bpmine/modules_uino/README.md

# modules_uino
Quelques modules à base d'arduino
