bpmine/modules_uino/oisuino/readme.md

# CABANE OISEAU connectée

Dérivé de la cabane minou

- Détection mouvement
- Bandeau à LEDs
- Température
- Connection MQTT
