bpmine/modules_uino/semuino/images/illustrations.pptx

Nano

(Maître I²C)

I²C

RTC

5V

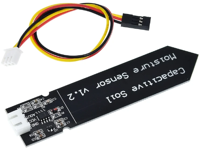
[picture p7: figure]

Humidity 1

Humidity 2

Humidity 3

DHT22
(Temp. / Hum.)

RGB1

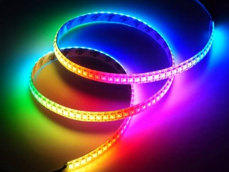
[picture p8: figure]

RGB2

RGB3

LED P1

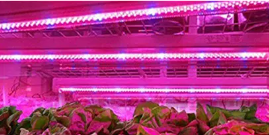
[picture p9: figure]

Sélecteur

LED P2

LED P3

## Slide 2

Nano

I²C

RTC

5V

Humidity 1

Humidity 2

Humidity 3

DHT22
(Temp. / Hum.)

RGB1

RGB2

RGB3

LED P1

Sélecteur

LED P2

LED P3

## Slide 3

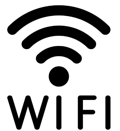
[picture p10: figure]

ESP01

(Maître I²C)

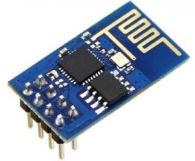
[picture p11: figure]

Ecran

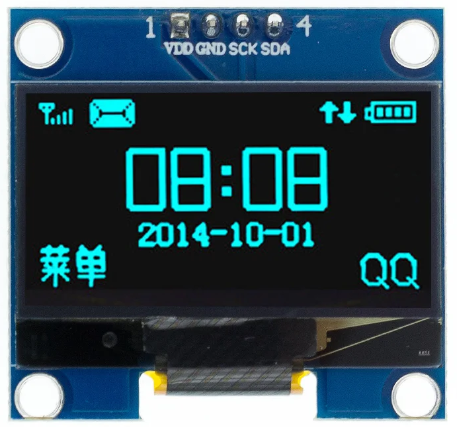
[picture p12: figure]
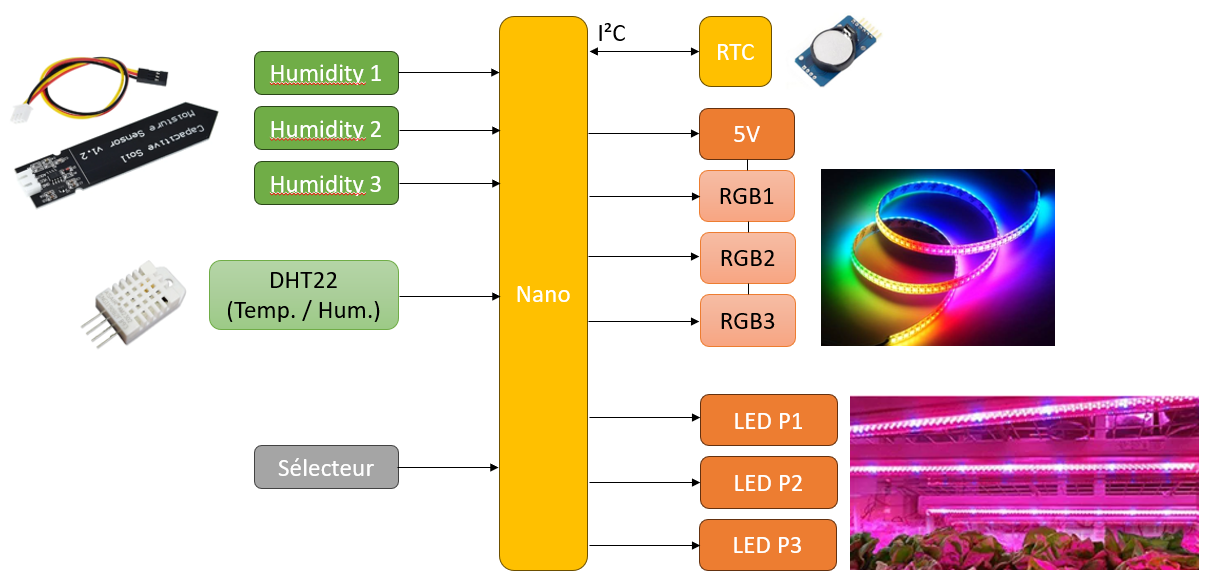
[picture p13: figure]
