bpmine/modules_uino/sonnette/doc.docx

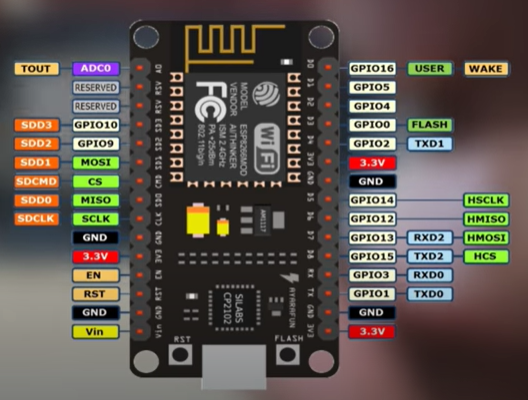
[picture p14: figure]

https://randomnerdtutorials.com/esp8266-pinout-reference-gpios/

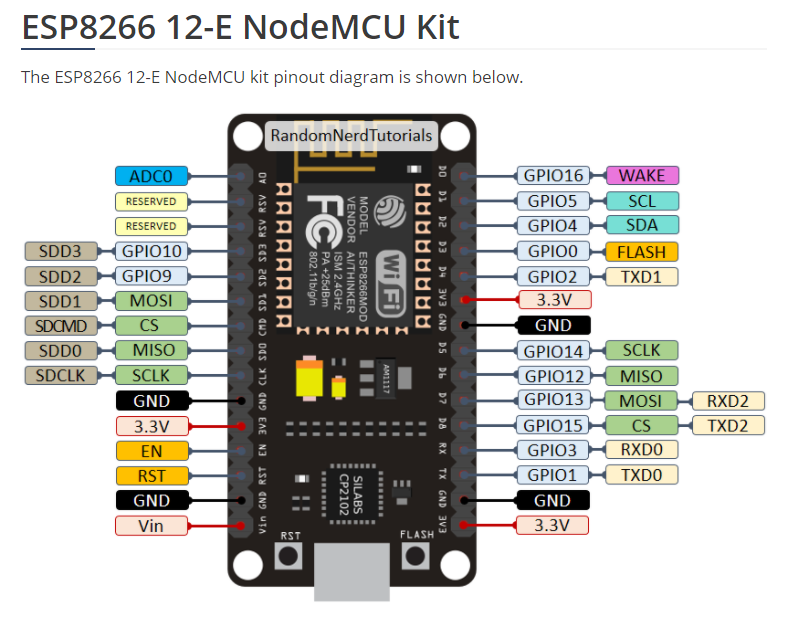
[picture p15: figure]
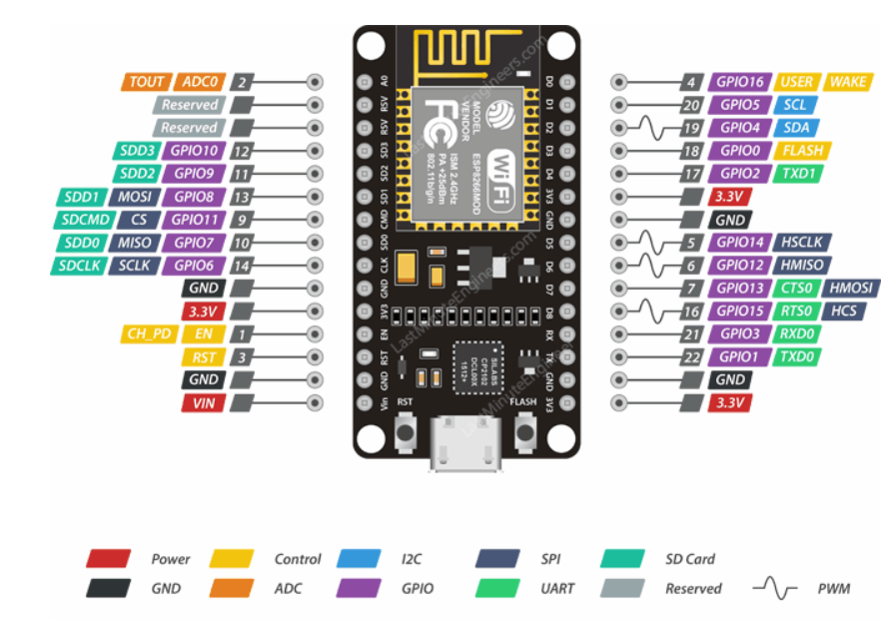
[picture p16: figure]
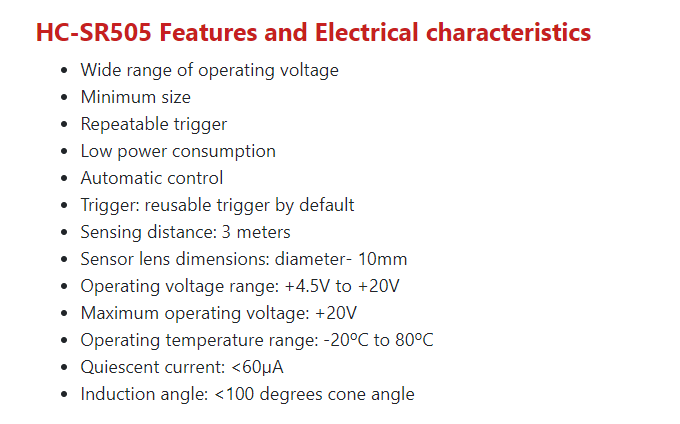
[picture p17: figure]
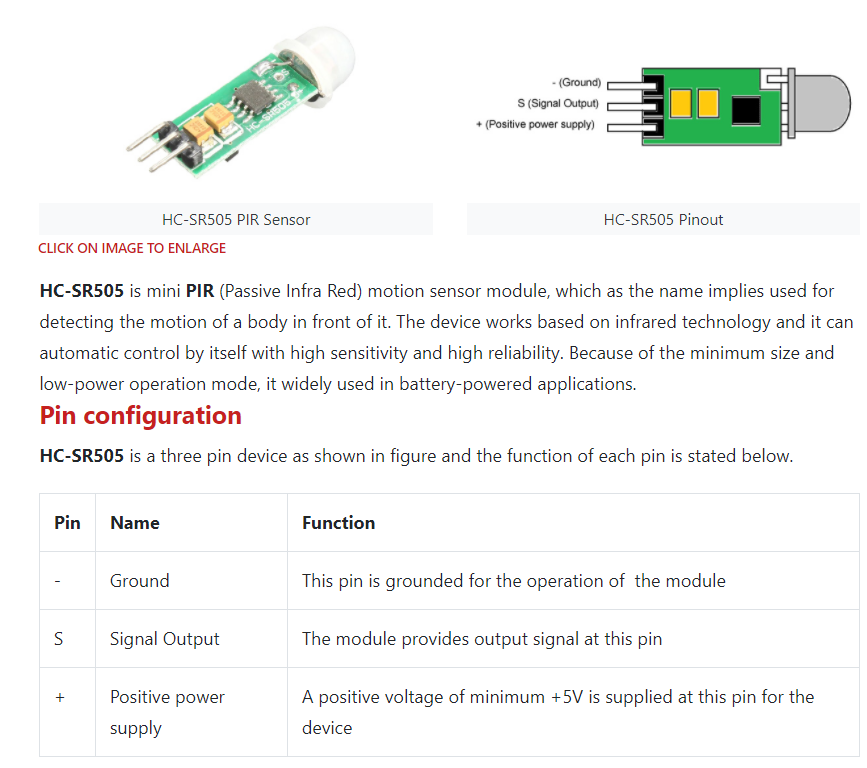
[picture p18: figure]
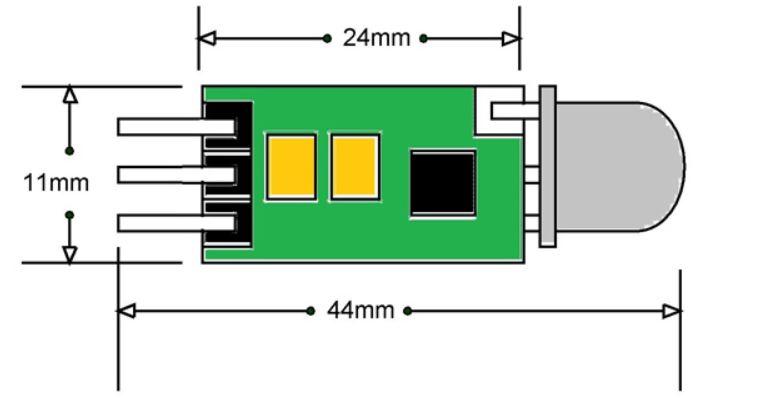
[picture p19: figure]
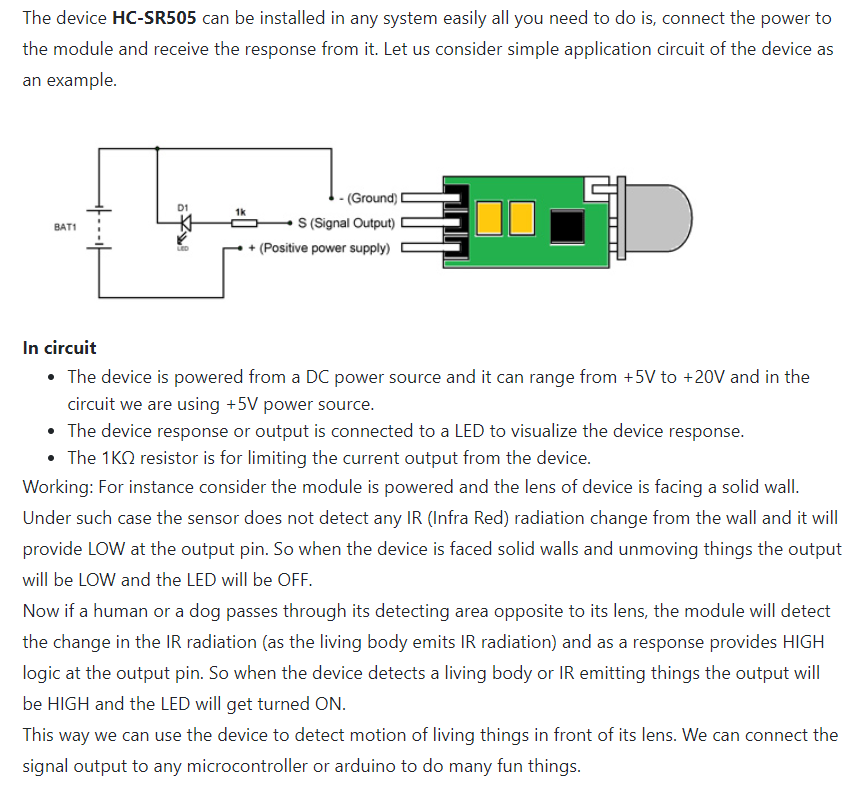
[picture p20: figure]
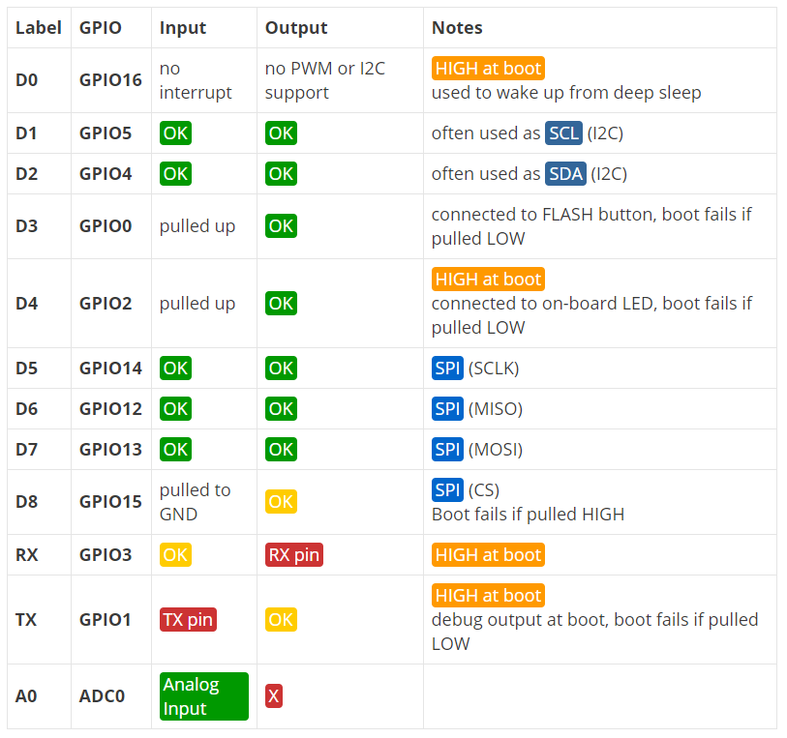
[picture p21: figure]
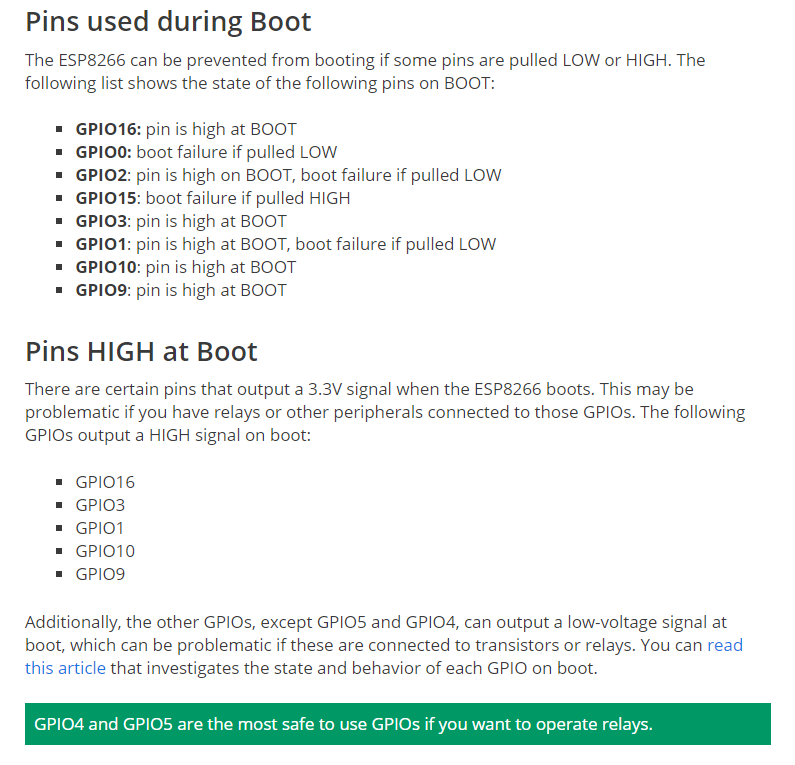
[picture p22: figure]
