bpmine/modules_uino/semuino/images/eclairage_blanc.png

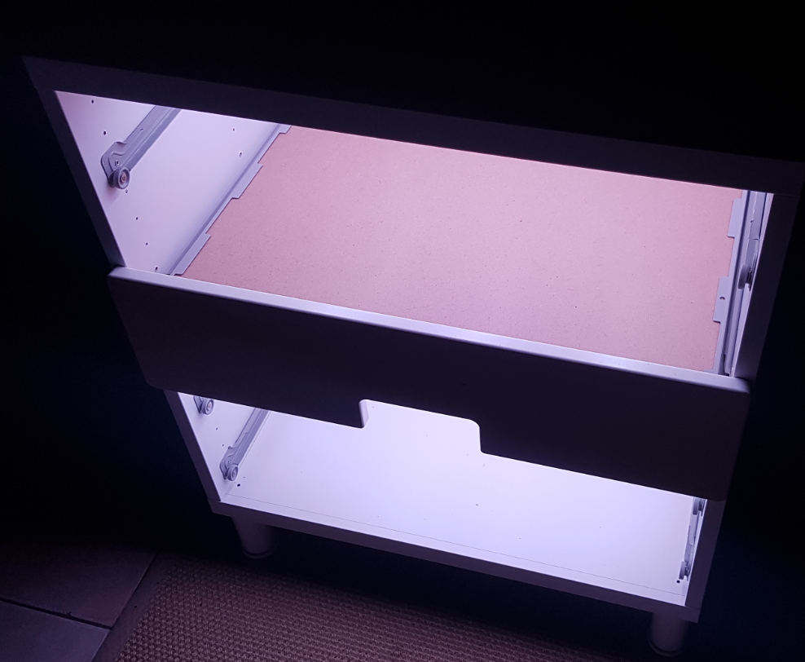
semuino/images/eclairage_blanc.png
