bpmine/modules_uino/semuino/images/eclairage_violet.png

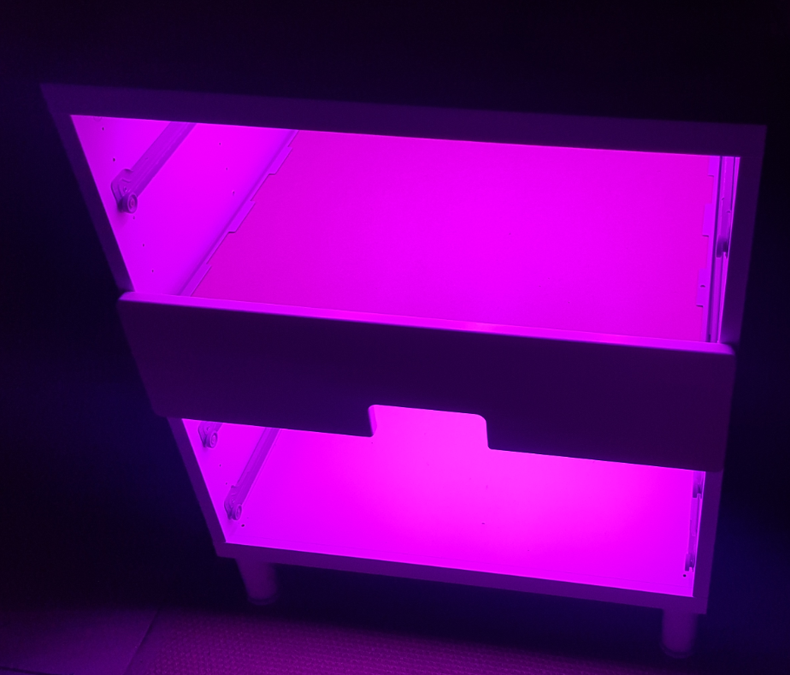
semuino/images/eclairage_violet.png
