bpmine/modules_uino/semuino/images/leds_tiroir.png

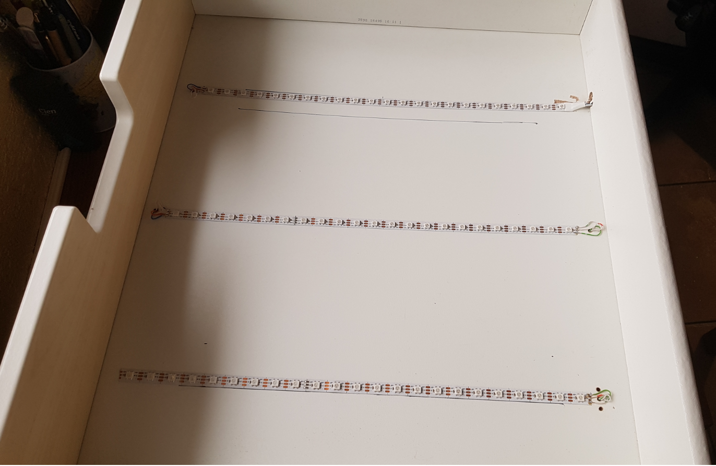
semuino/images/leds_tiroir.png
