bpmine/modules_uino/lcduino/hard/montage.FCStd

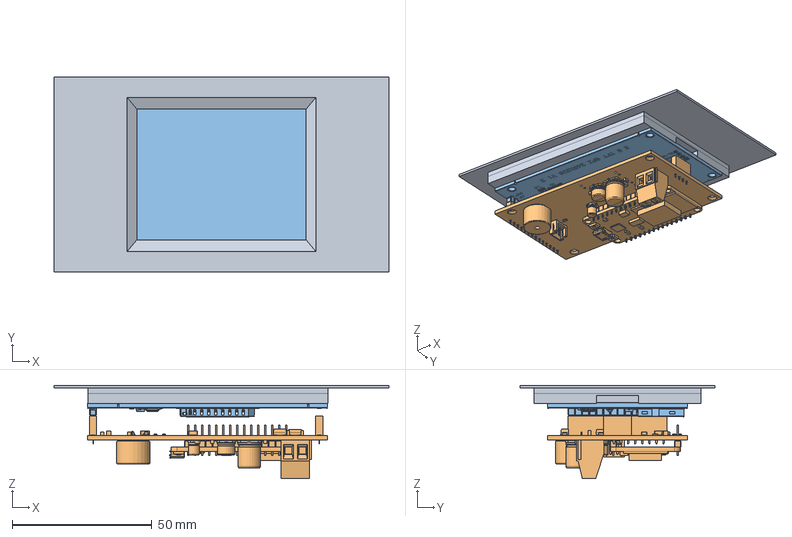
[picture p29: CAD file, 2026-10-17]
lcduino/hard/montage.FCStd
120.0 x 70.0 x 33.5 mm
lcduino
LCD_MSP2807_fusion
