bpmine/modules_uino/semuino/resultats.md

# Resultats

## Mesures avec le montage initial

Bandeau à LEDs de type WS2812B 5V 60LEDs/m 18W/m

Nombre de LEDs : 23 x 3 = 69

Temperature de la pièce: 20.5°C

Description | Mesure éclairage | Puissance électrique
-- | -- | --
Eclairage en 80%R / 20%B | 30 lux | 3,53 W
Eclairage en blanc | 660 lux | 7,38 W

Résultat: La lumière est insuffisante pour les premiers semis. Les plants montent trop vite.

## Mesures avec un dispositif horticole du marché

Nombre de LEDs : 20 x 3 = 60

Description | Mesure éclairage | Puissance électrique
-- | -- | --
Eclairage Rose/Violet 39 LEDs | 1018 lux | 6,33 W
Eclairage 39 rouges + 21 bleues | 213 lux | 8,96 W
Eclairage 21 bleues | 0 lux | 3,847 W

Les 0 lux obtenus avec le bleu sont dus à l'outil de mesure qui visiblement ne prend pas en compte la composante bleue.

## Mise à jour du dispositif avec plus de LEDs

On ajoute 4 rangées de LEDs WS2812B sur l'étage du haut.

Nombre de LEDs : 23 x 7 = 161

Description | Mesure éclairage | Puissance électrique
-- | -- | --
Eclairage en 80%R / 20%B | 90 lux | 7,70 W
Eclairage en blanc | 1553 lux | 13,25 W

Test en cours avec les mêmes plants repiqués dans des pots plus grands

## Mise à jour de l'étage du bas

On ajoute 4 rangées de LEDs WS2812B sur l'étage du haut.

Nombre de LEDs : 23 x 7 = 161

La consommation totale passe à 3.84A pour 5.08V, soit une puissance de 19.51W pour un éclairage blanc à 100% en haut et en bas.

Test en cours avec les mêmes plants repiqués dans des pots plus grands
