bpmine/modules_uino/(list of files, drawings)

Other design files:
semuino/schematic.fzz
sonnette/sonnette.fzz
