bpmine/modules_uino/lcduino/hard/lcduino.kicad_pcb

## KiCad design lcduino/hard/lcduino.kicad_pcb (2026-10-16)

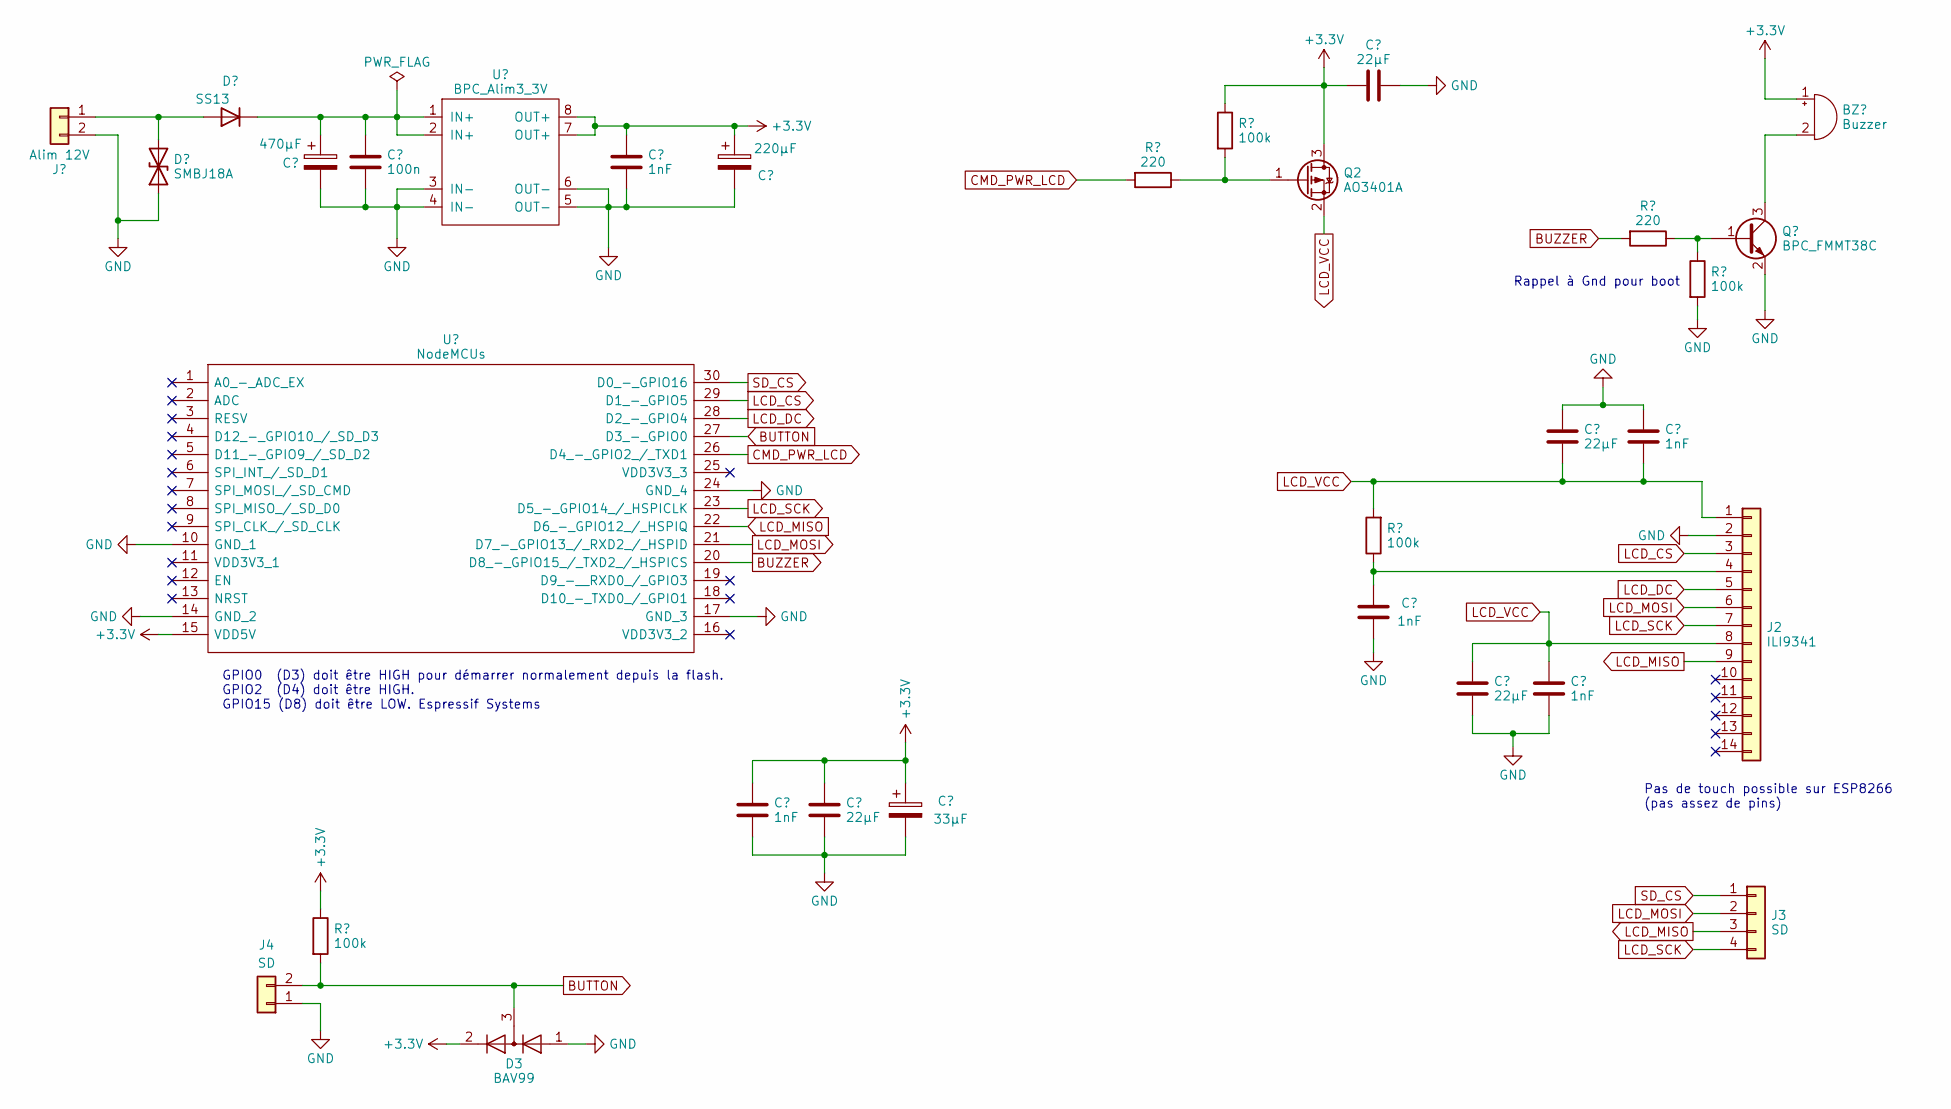
[picture p30: schematic lcduino.kicad_sch, Carte LCD Wifi]

Parts:
BZ1: Buzzer; MagneticBuzzer_ProSignal_ABT-410-RC
C1: 470µF; CP_Elec_8x10
C2: 100n; C_0805_2012Metric_Pad1.18x1.45mm_HandSolder
C3, C5, C8, C9, C13: 1nF; C_0805_2012Metric_Pad1.18x1.45mm_HandSolder
C4: 220µF; CP_Elec_6.3x5.3
C6, C10, C11, C12: 22µF; C_1206_3216Metric_Pad1.33x1.80mm_HandSolder
C7: 33µF; CP_Elec_4x5.3
D1: SMBJ18A; D_SMB_Handsoldering
D2: SS13; D_SMA
D3: BAV99; SOT-23
J1: Alim 12V; TerminalBlock_Phoenix_MKDS-1,5-2-5.08_1x02_P5.08mm_Horizont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
J2: ILI9341; PinSocket_1x14_P2.54mm_Vertical
J3: SD; PinSocket_1x04_P2.54mm_Vertical
J4: SD; JST_EH_B2B-EH-A_1x02_P2.50mm_Vertical
Q1: BPC_FMMT38C; BPC_SOT-23-3_HandSoldering
Q2: AO3401A; SOT-23
R1, R3: 220; R_0805_2012Metric_Pad1.20x1.40mm_HandSolder
R2, R4, R5, R6: 100k; R_0805_2012Metric_Pad1.20x1.40mm_HandSolder
U1: NodeMCUs; BPC_NodeMCU_small; Manufacturer_Part_Number 113990105; Mouser Part Number 713-113990105
U2: BPC_Alim3_3V

Connections:
+3.3V: BZ1.1 (-), C3.1, C4.1, C5.1, C6.1, C7.1, C11.1, D3.2 (A), Q2.3 (D), R4.1, R6.1, U1.15 (VDD5V), U2.7 (OUT+), U2.8 (OUT+)
BUTTON: D3.3 (K), J4.2, R6.2, U1.27 (D3_-_GPIO0)
BUZZER: R1.2, U1.20 (D8_-_GPIO15_/_TXD2_/_HSPICS)
CMD_PWR_LCD: R3.2, U1.26 (D4_-_GPIO2_/_TXD1)
GND: C1.2, C2.2, C3.2, C4.2, C5.2, C6.2, C7.2, C8.1, C9.1, C10.1, C11.2, C12.2, C13.2, D1.1 (A1), D3.1 (K), J1.2, J2.2, J4.1, Q1.2 (E), R5.2, U1.10 (GND_1), U1.14 (GND_2), U1.17 (GND_3), U1.24 (GND_4), U2.3 (IN-), U2.4 (IN-), U2.5 (OUT-), U2.6 (OUT-)
LCD_CS: J2.3, U1.29 (D1_-_GPIO5)
LCD_DC: J2.5, U1.28 (D2_-_GPIO4)
LCD_MISO: J2.9, J3.3, U1.22 (D6_-_GPIO12_/_HSPIQ)
LCD_MOSI: J2.6, J3.2, U1.21 (D7_-_GPIO13_/_RXD2_/_HSPID)
LCD_SCK: J2.7, J3.4, U1.23 (D5_-_GPIO14_/_HSPICLK)
LCD_VCC: C9.2, C10.2, C12.1, C13.1, J2.1, J2.8, Q2.2 (S), R2.2
unnamed: BZ1.2 (+), Q1.3 (C)
unnamed: D1.2 (A2), D2.2 (A), J1.1
unnamed: C1.1, C2.1, D2.1 (K), U2.1 (IN+), U2.2 (IN+)
unnamed: C8.2, J2.4, R2.1
unnamed: Q1.1 (B), R1.1, R5.1
unnamed: Q2.1 (G), R3.1, R4.2
SD_CS: J3.1, U1.30 (D0_-_GPIO16)

Notes on the sheet:
GPIO0 (D3) doit être HIGH pour démarrer normalement depuis la flash. GPIO2 (D4) doit être HIGH. GPIO15 (D8) doit être LOW. Espressif Systems
Pas de touch possible sur ESP8266 (pas assez de pins)
Rappel à Gnd pour boot

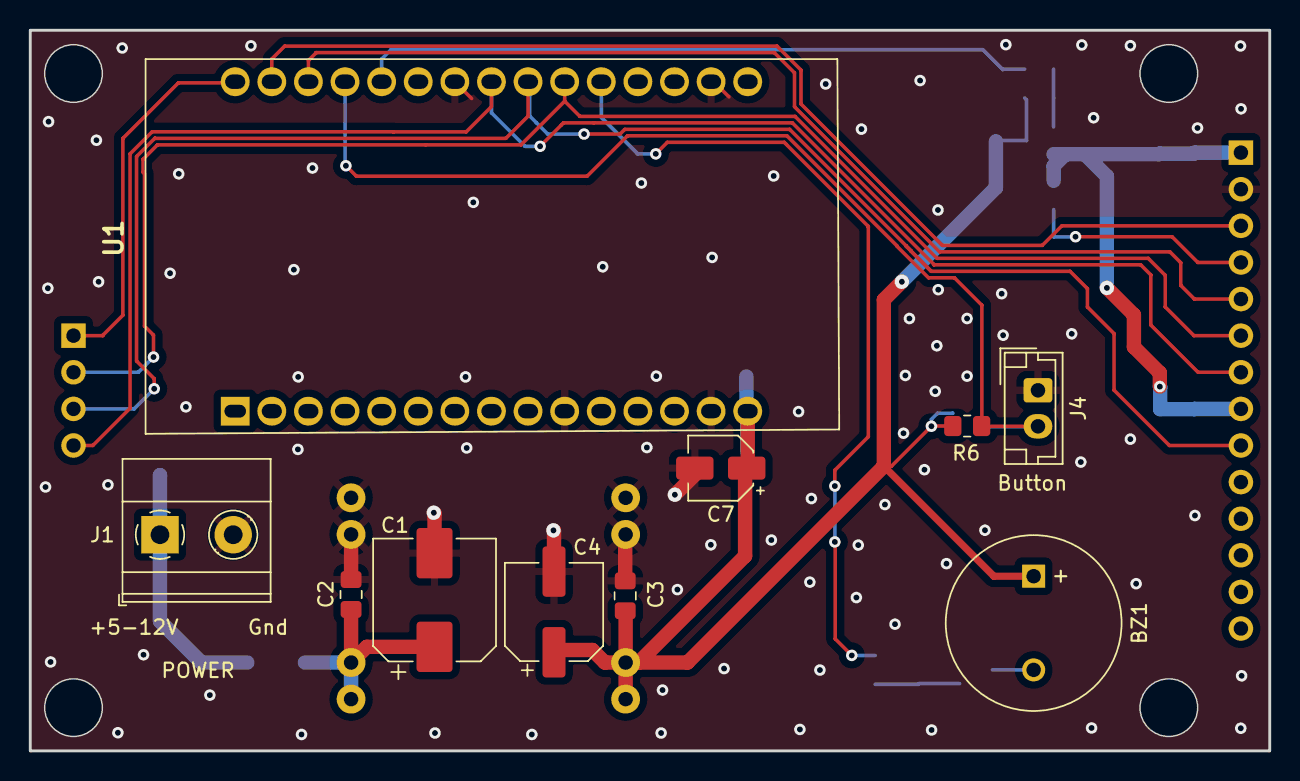
[picture p31: board lcduino.kicad_pcb from above]

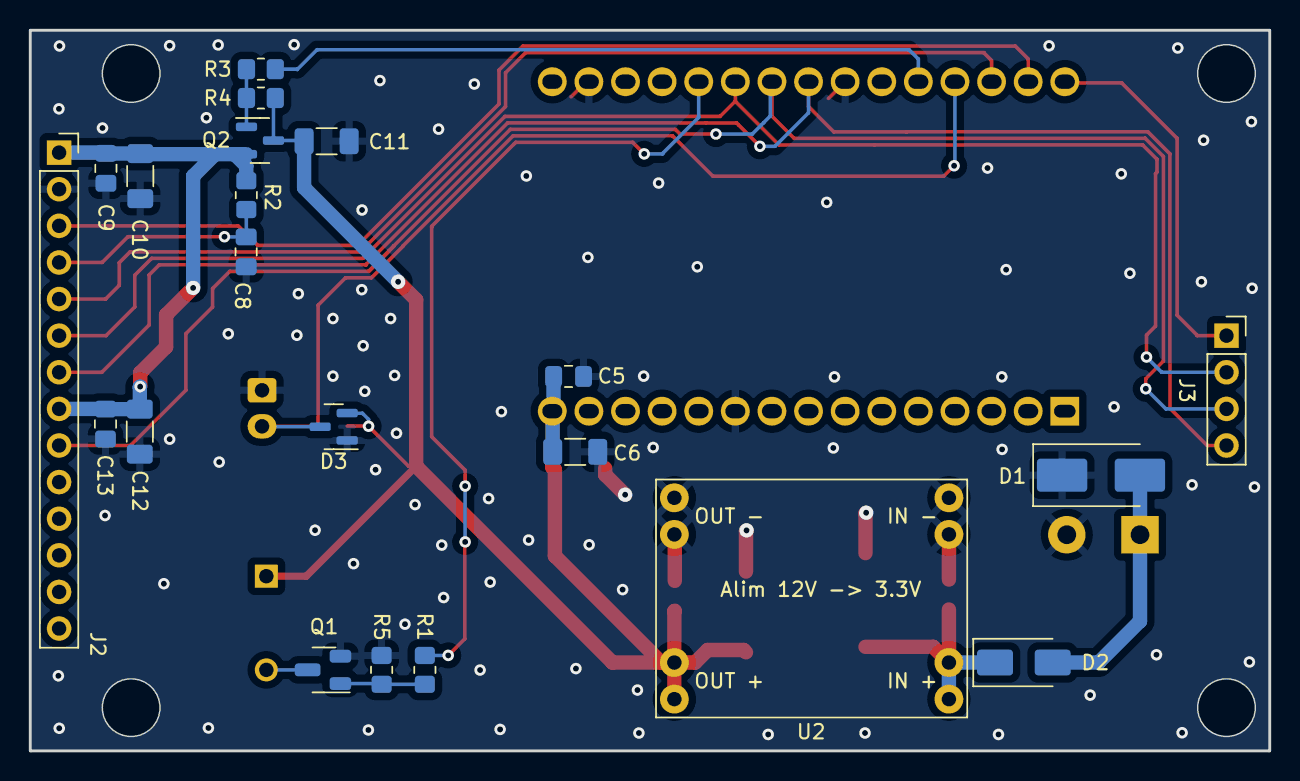
[picture p32: board lcduino.kicad_pcb from below]

Board: 2 copper layers, 86.0 x 50.0 mm, 31 parts (21 on the bottom side), 18 nets.
