bpmine/modules_uino/logger/logger/logger.kicad_pcb

## KiCad design logger/logger/logger.kicad_pcb (2024-06-10)

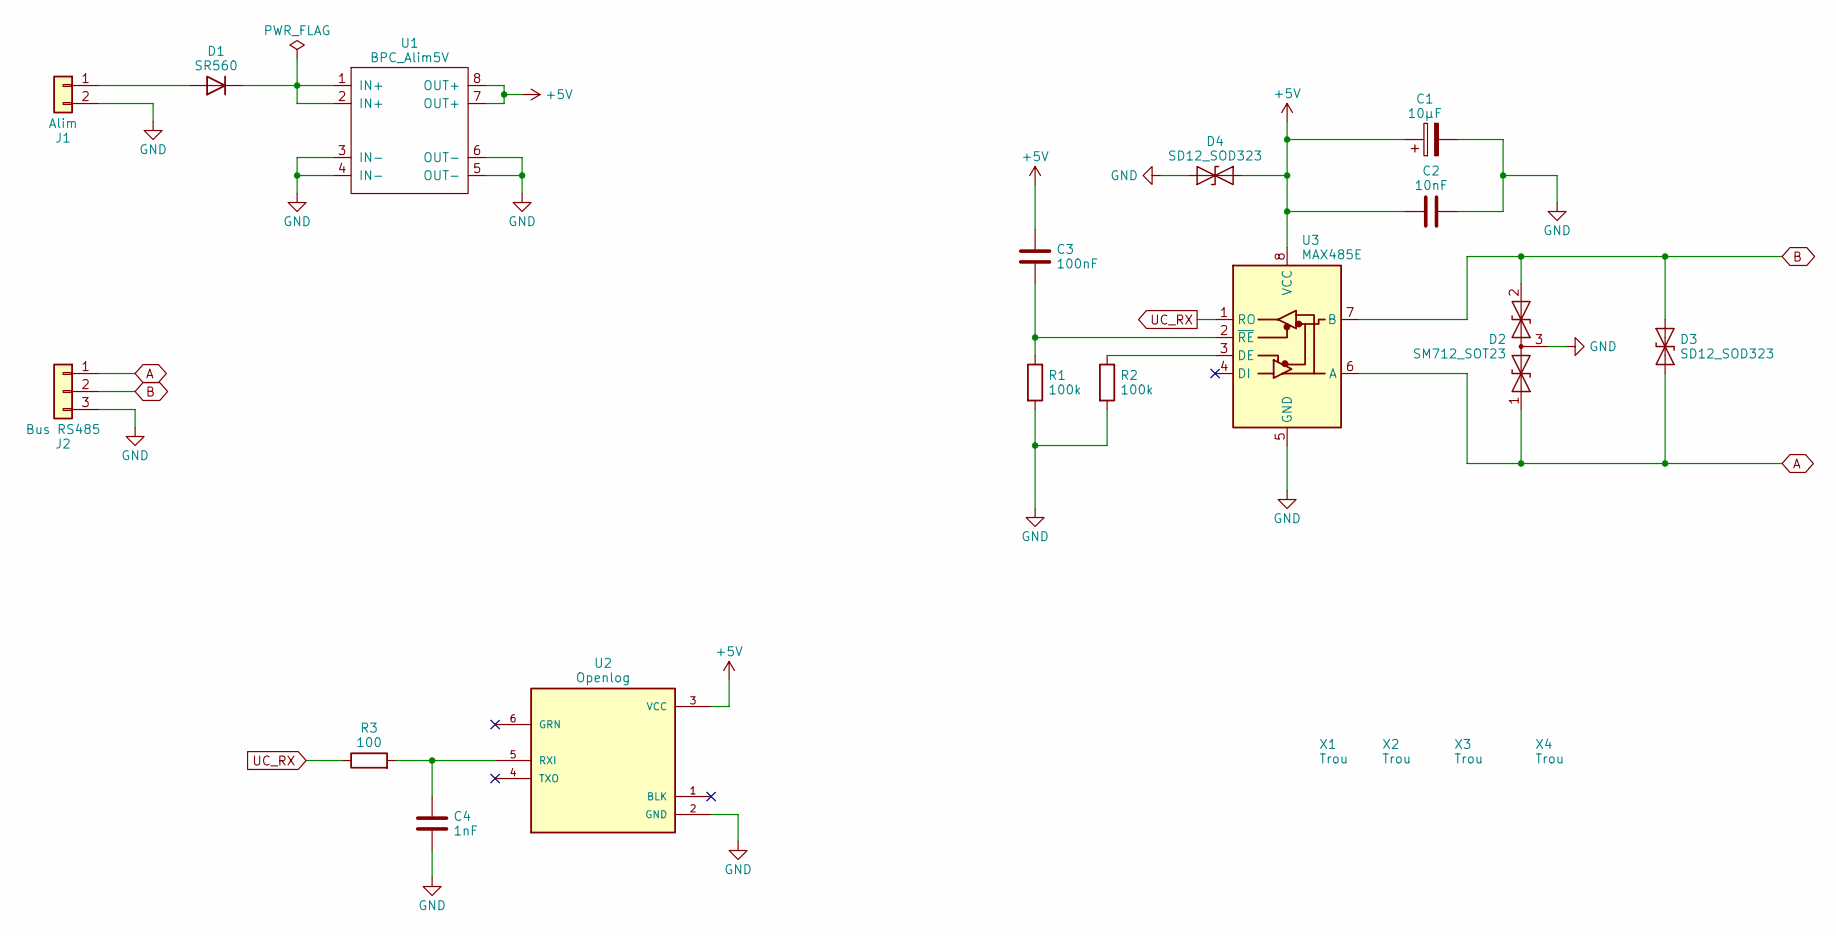
[picture p33: schematic logger.kicad_sch, Datalogger RS485]

Parts:
C1: 10µF; C_0805_2012Metric_Pad1.18x1.45mm_HandSolder
C2: 10nF; C_0805_2012Metric_Pad1.18x1.45mm_HandSolder
C3: 100nF; C_0805_2012Metric_Pad1.18x1.45mm_HandSolder
C4: 1nF; C_0805_2012Metric_Pad1.18x1.45mm_HandSolder
D1: SR560; D_DO-15_P12.70mm_Horizontal
D2: SM712_SOT23; SOT-23
D3, D4: SD12_SOD323; D_SOD-323
J1: Alim; TerminalBlock_Phoenix_MPT-0,5-2-2.54_1x02_P2.54mm_Horizontal
J2: Bus RS485; TerminalBlock_Phoenix_MPT-0,5-3-2.54_1x03_P2.54mm_Horizontal
R1, R2: 100k; R_0805_2012Metric_Pad1.20x1.40mm_HandSolder
R3: 100; R_0805_2012Metric_Pad1.20x1.40mm_HandSolder
U1: BPC_Alim5V
U2: Openlog; BPC_openlog; PARTREV v15
U3: MAX485E; BPC_MAX485E_SOIC127P600X175-8N
X1, X2, X3, X4: Trou; BPC_Trou4mm_Fixation

Connections:
+5V: C1.1, C2.1, C3.2, D4.1 (A1), U1.7 (OUT+), U1.8 (OUT+), U2.3 (VCC), U3.8 (VCC)
A: D2.1 (A1), D3.1 (A1), J2.1, U3.6 (A)
B: D2.2 (A2), D3.2 (A2), J2.2, U3.7 (B)
GND: C1.2, C2.2, C4.1, D2.3 (common), D4.2 (A2), J1.2, J2.3, R1.2, R2.2, U1.3 (IN-), U1.4 (IN-), U1.5 (OUT-), U1.6 (OUT-), U2.2 (GND), U3.5 (GND)
unnamed: D1.2 (A), J1.1
unnamed: D1.1 (K), U1.1 (IN+), U1.2 (IN+)
unnamed: C4.2, R3.2, U2.5 (RXI)
unnamed: R2.1, U3.3 (DE)
unnamed: C3.1, R1.1, U3.2 (~RE)
UC_RX: R3.1, U3.1 (RO)

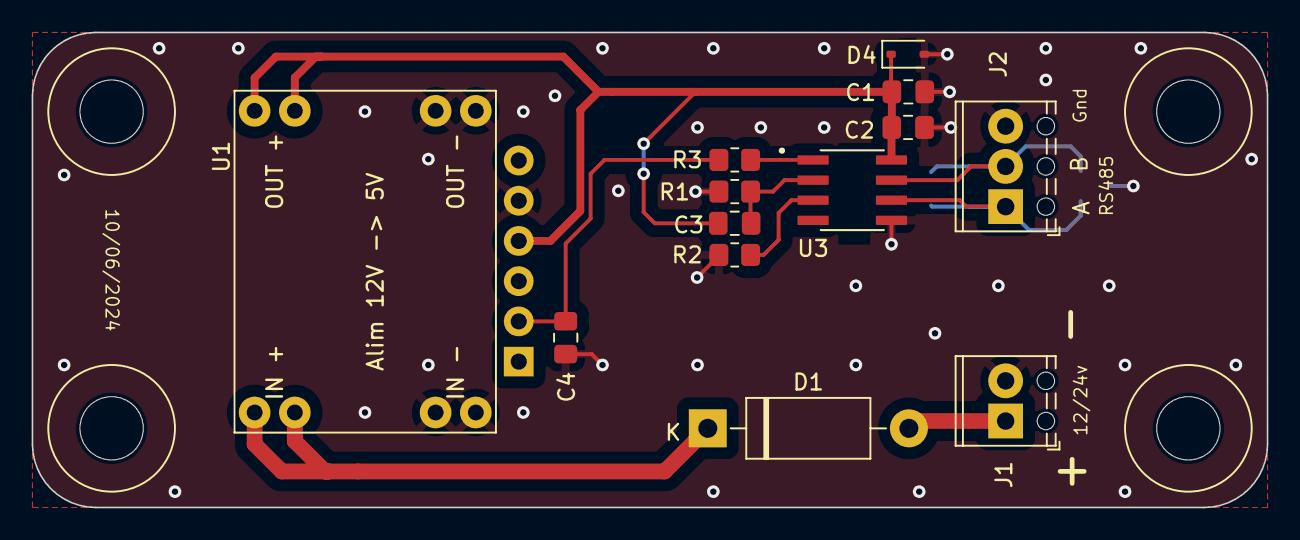
[picture p34: board logger.kicad_pcb from above]

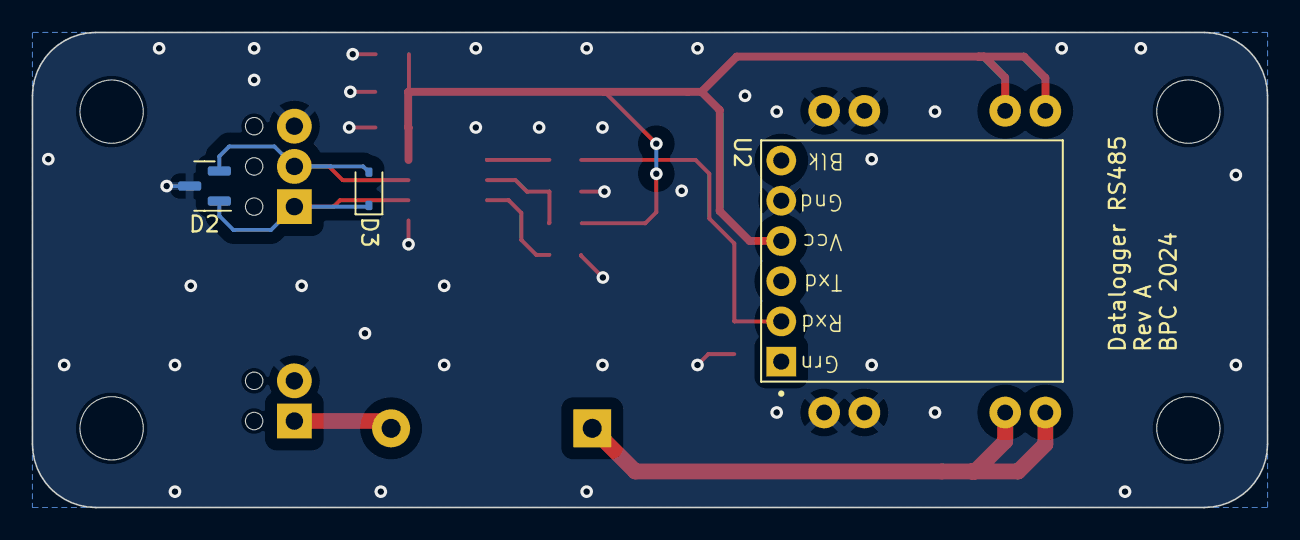
[picture p35: board logger.kicad_pcb from below]

Board: 2 copper layers, 78.0 x 30.0 mm, 20 parts (3 on the bottom side), 10 nets.
