bpmine/modules_uino/semuino/board/semuino/semuino.kicad_pcb

## KiCad design semuino/board/semuino/semuino.kicad_pcb (2023-12-23)

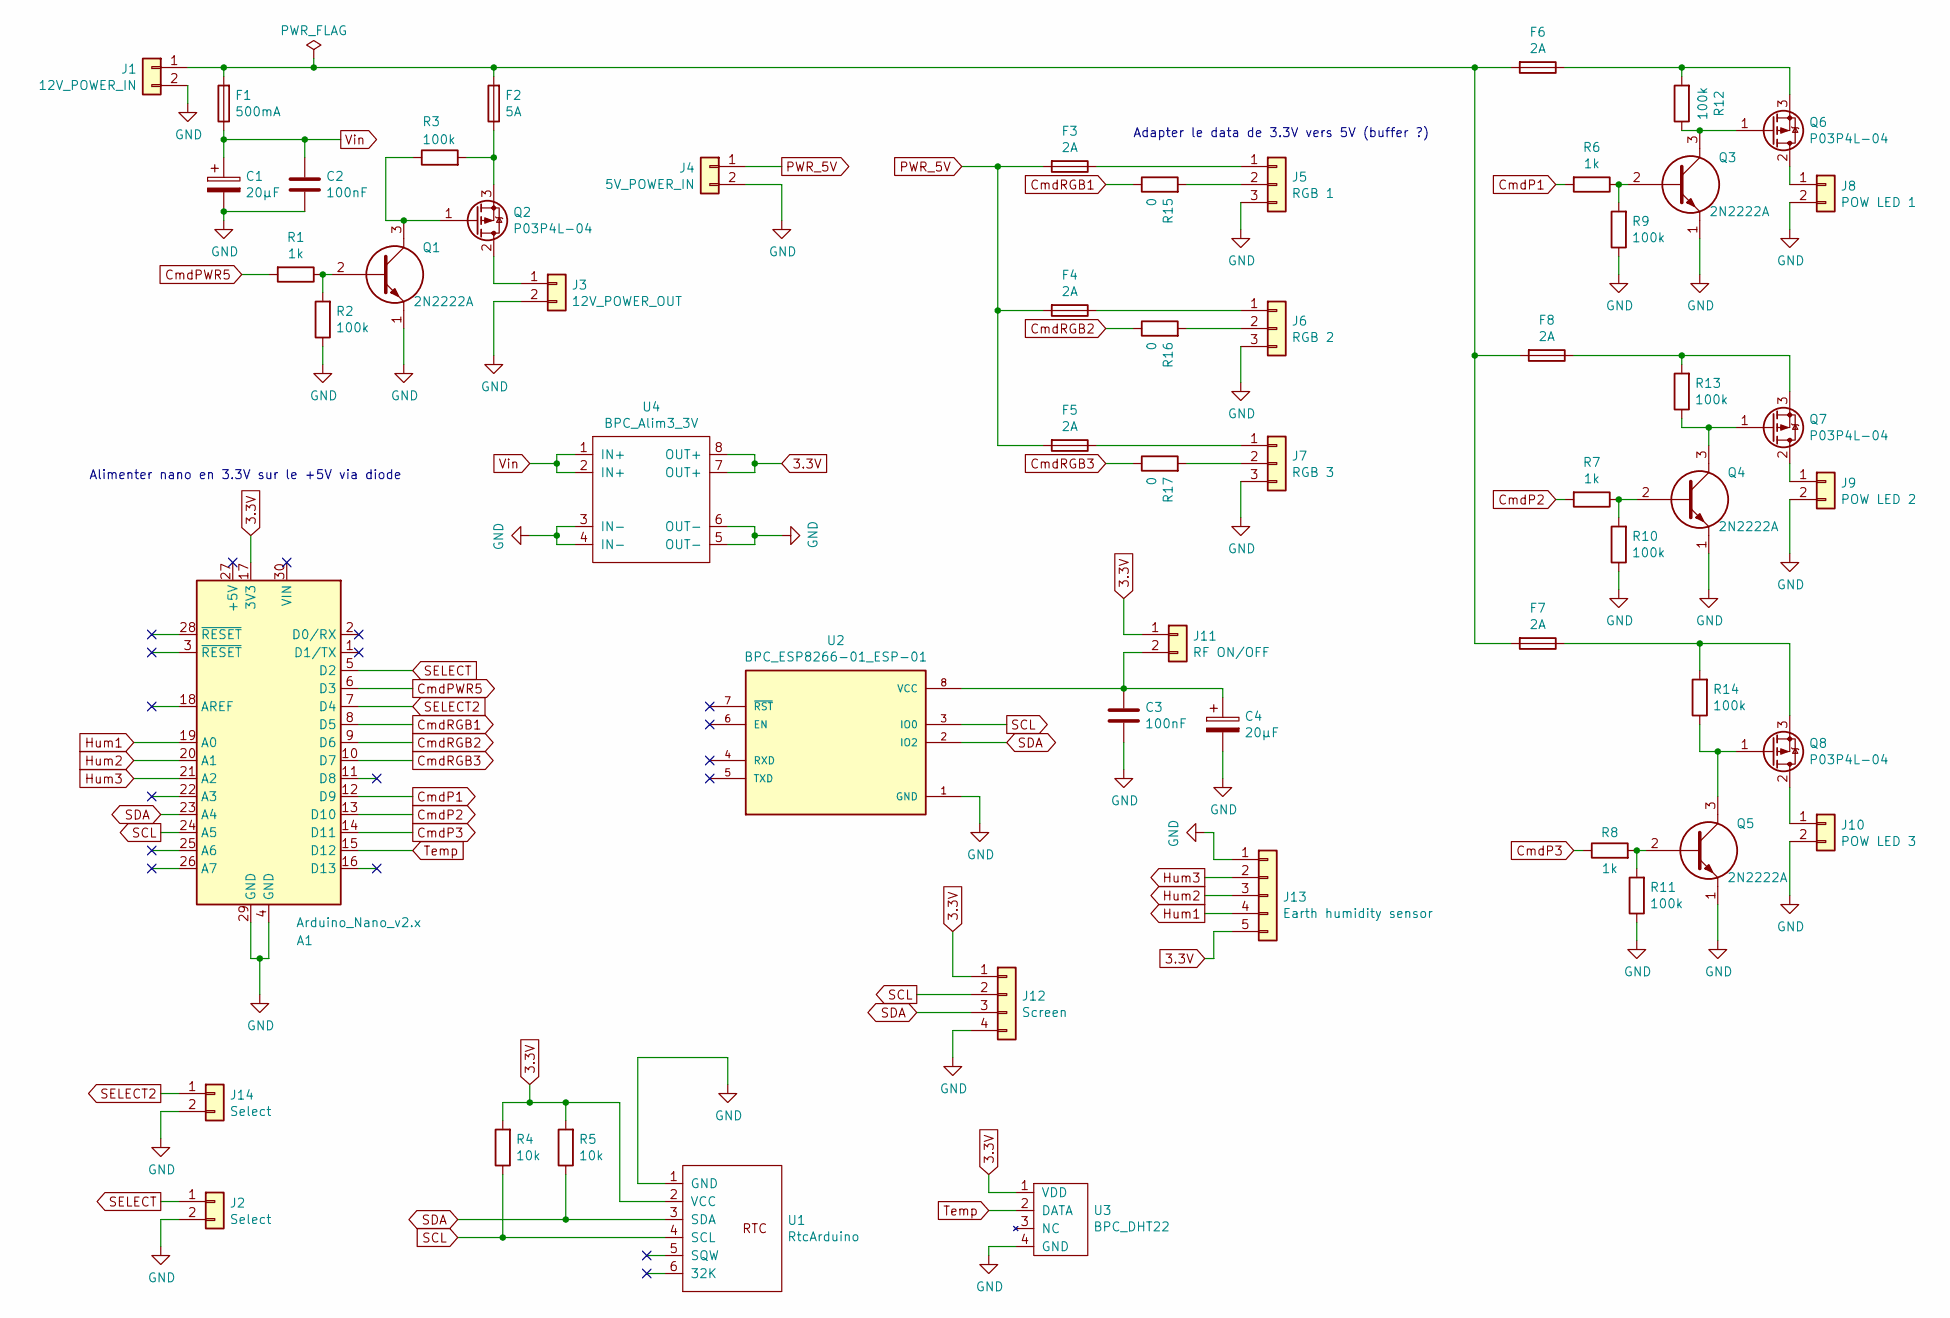
[picture p36: schematic semuino.kicad_sch, Semuino - Contrôleur de meuble à semis]

Parts:
A1: Arduino_Nano_v2.x; BPC_Arduino_Nano
C1, C4: 20µF; CP_Radial_D8.0mm_P3.80mm
C2, C3: 100nF; C_Disc_D7.0mm_W2.5mm_P5.00mm
F1: 500mA; Fuseholder_TR5_Littelfuse_No560_No460
F2: 5A; Fuseholder_Clip-5x20mm_Littelfuse_520_Inline_P20.50x5.80mm_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
F3, F4, F5, F6, F7, F8: 2A; Fuseholder_TR5_Littelfuse_No560_No460
J1: 12V_POWER_IN; TerminalBlock_Phoenix_MKDS-1,5-2_1x02_P5.00mm_Horizontal
J2, J14: Select; PinHeader_1x02_P2.54mm_Vertical
J3: 12V_POWER_OUT; TerminalBlock_Phoenix_MKDS-1,5-2_1x02_P5.00mm_Horizontal
J4: 5V_POWER_IN; TerminalBlock_Phoenix_MPT-0,5-2-2.54_1x02_P2.54mm_Horizontal
J5: RGB 1; TerminalBlock_Phoenix_MPT-0,5-3-2.54_1x03_P2.54mm_Horizontal
J6: RGB 2; TerminalBlock_Phoenix_MPT-0,5-3-2.54_1x03_P2.54mm_Horizontal
J7: RGB 3; TerminalBlock_Phoenix_MPT-0,5-3-2.54_1x03_P2.54mm_Horizontal
J8: POW LED 1; TerminalBlock_Phoenix_MKDS-1,5-2_1x02_P5.00mm_Horizontal
J9: POW LED 2; TerminalBlock_Phoenix_MKDS-1,5-2_1x02_P5.00mm_Horizontal
J10: POW LED 3; TerminalBlock_Phoenix_MKDS-1,5-2_1x02_P5.00mm_Horizontal
J11: RF ON/OFF; PinHeader_1x02_P2.54mm_Vertical
J12: Screen; JST_XH_B4B-XH-A_1x04_P2.50mm_Vertical
J13: Earth humidity sensor; TerminalBlock_Phoenix_MPT-0,5-5-2.54_1x05_P2.54mm_Horizontal
Q1, Q3, Q4, Q5: 2N2222A; TO-92; Manufacturer_Part_Number 2N2222A; Mouser Part Number 494-2N2222A
Q2, Q6, Q7, Q8: P03P4L-04; TO-220-3_Vertical
R1, R6, R7, R8: 1k; R_Axial_DIN0309_L9.0mm_D3.2mm_P2.54mm_Vertical
R2, R3, R9, R10, R11, R12, R13, R14: 100k; R_Axial_DIN0309_L9.0mm_D3.2mm_P2.54mm_Vertical
R4, R5: 10k; R_Axial_DIN0309_L9.0mm_D3.2mm_P12.70mm_Horizontal
R15, R16, R17: 0; R_Axial_DIN0309_L9.0mm_D3.2mm_P2.54mm_Vertical
U1: RtcArduino; BPC_RtcArduino
U2: BPC_ESP8266-01_ESP-01; BPC_XCVR_ESP8266-01_ESP-01; PARTREV V1.2
U3: BPC_DHT22
U4: BPC_Alim3_3V

Connections:
3.3V: A1.17 (3V3), J11.1, J12.1, J13.5, R4.2, R5.2, U1.2 (VCC), U3.1 (VDD), U4.7 (OUT+), U4.8 (OUT+)
CmdP1: A1.12 (D9), R6.2
CmdP2: A1.13 (D10), R7.2
CmdP3: A1.14 (D11), R8.1
CmdPWR5: A1.6 (D3), R1.2
CmdRGB1: A1.8 (D5), R15.1
CmdRGB2: A1.9 (D6), R16.1
CmdRGB3: A1.10 (D7), R17.1
GND: A1.4 (GND), A1.29 (GND), C1.2, C2.2, C3.2, C4.2, J1.2, J2.2, J3.2, J4.2, J5.3, J6.3, J7.3, J8.2, J9.2, J10.2, J12.4, J13.1, J14.2, Q1.1, Q3.1, Q4.1, Q5.1, R2.1, R9.1, R10.1, R11.1, U1.1 (GND), U2.1 (GND), U3.4 (GND), U4.3 (IN-), U4.4 (IN-), U4.5 (OUT-), U4.6 (OUT-)
Hum1: A1.19 (A0), J13.4
Hum2: A1.20 (A1), J13.3
Hum3: A1.21 (A2), J13.2
unnamed: F1.2, F2.2, F6.2, F7.2, F8.2, J1.1
unnamed: J3.1, Q2.2 (D)
unnamed: F3.1, J5.1
unnamed: J5.2, R15.2
unnamed: F4.1, J6.1
unnamed: J6.2, R16.2
unnamed: F5.1, J7.1
unnamed: J7.2, R17.2
unnamed: J8.1, Q6.2 (D)
unnamed: J9.1, Q7.2 (D)
unnamed: J10.1, Q8.2 (D)
unnamed: C3.1, C4.1, J11.2, U2.8 (VCC)
unnamed: Q1.2, R1.1, R2.2
unnamed: Q1.3, Q2.1 (G), R3.1
unnamed: F2.1, Q2.3 (S), R3.2
unnamed: Q3.2, R6.1, R9.2
unnamed: Q4.2, R7.1, R10.2
unnamed: Q5.2, R8.2, R11.2
unnamed: Q3.3, Q6.1 (G), R12.1
unnamed: F6.1, Q6.3 (S), R12.2
unnamed: Q4.3, Q7.1 (G), R13.1
unnamed: F8.1, Q7.3 (S), R13.2
unnamed: Q5.3, Q8.1 (G), R14.1
unnamed: F7.1, Q8.3 (S), R14.2
PWR_5V: F3.2, F4.2, F5.2, J4.1
SCL: A1.24 (A5), J12.2, R4.1, U1.4 (SCL), U2.3 (IO0)
SDA: A1.23 (A4), J12.3, R5.1, U1.3 (SDA), U2.2 (IO2)
SELECT: A1.5 (D2), J2.1
SELECT2: A1.7 (D4), J14.1
Temp: A1.15 (D12), U3.2 (DATA)
Vin: C1.1, C2.1, F1.1, U4.1 (IN+), U4.2 (IN+)

Notes on the sheet:
Alimenter nano en 3.3V sur le +5V via diode
Adapter le data de 3.3V vers 5V (buffer ?)

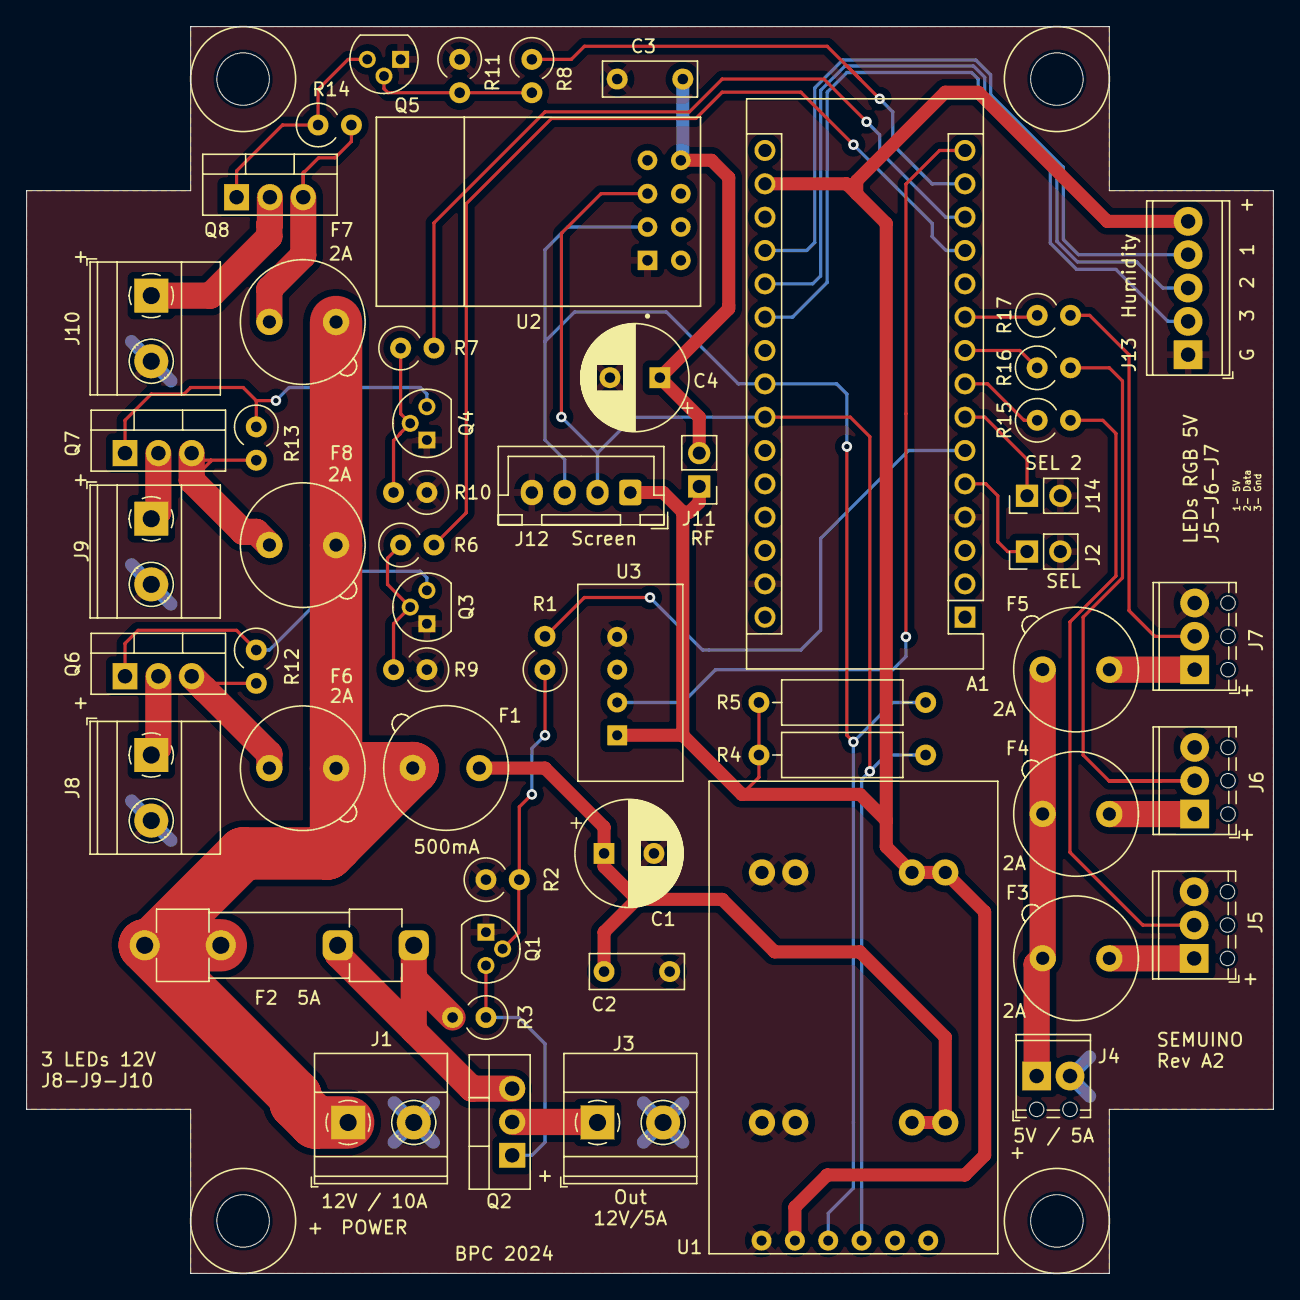
[picture p37: board semuino.kicad_pcb from above]

Board: 2 copper layers, 95.0 x 95.0 mm, 56 parts (1 on the bottom side), 43 nets.
