bpmine/modules_uino/semuino/semuino_esp01_master/timer.h

/**
 * @file timer.h
 * @brief Header - Gestion d'un timer en ms
*/
#ifndef TIMER_HEADER_INCLUDED
#define TIMER_HEADER_INCLUDED

/**
 * @class Timer
 * @brief Classe de gestion d'un timer en ms
*/
class Timer
{
  private:
    unsigned long tick0_ms;
    unsigned long duration_ms;   
    bool running; 
    bool single;
  
  public:
    Timer(unsigned long duration_ms=1000,bool single=true);

    bool tick(void);
    void setDuration_ms(unsigned long duration_ms); 
    void stop(void);
    void start(void);   

    bool isRunning(void);
    unsigned long getRemaining_ms(void);
    unsigned long getDuration_ms(void);
};
#endif
