bpmine/modules_uino/oisuino/credentials.h

#define STASSID "Maison"
#define STAPSK  "C6EA0D7BBDB1D8E4B3F7F2A26D"

#define MQTT_IP     "13.36.44.120"
#define MQTT_LOGIN  "oiso" 
#define MQTT_PASS   "oiso69"
#define MQTT_ID     1

#define OTA_NAME    "Cabane Oiseaux"
