bpmine/modules_uino/(commit log)

2021-02-05 Lecteur de badge arduino avec sa lib python
2021-02-07 Création du projet semuino - Gestion du meuble de semis
2021-02-07 Ajout images + schéma
    [schematic.fzz]
2021-02-21 Modification des modes de fonctionnement: - Avoir étage du haut en blanc tout seul
2021-02-24 Schema de sonnette envoyé aujourd'hui pour tester Fritzing
    [sonnette.fzz]
2021-02-28 Mise à jour avec 4 rangées de LEDs en plus en haut les premiers semis n'ont pas eu assez de lumière !
2021-03-08 Diminuer sensibilité du détecteur de mouvement (>10s d'activité devant la sonnette)
2021-03-09 Tentative amélioration suite panne de reseau: - Si pas de wifi - ou pas de MQTT
    On fonctionne quand meme et on retente en tache de fond.
    Il reste un temps mort pendant la tentative MQTT ou on ne detecte pas l'appui.
2021-03-09 Connect que si publish pour eviter de se faire shooter En fait, la lib arduino n'envoi qu'en QoS 0 => On perd les messages qui sont transcient sur le broker !!!
    Faut changer la lib
    [sonnette.ino]
2021-03-09 Changement de lib MQTT pour https://github.com/arduino-libraries/ArduinoMqttClient
    Marche en QoS 1 => Messages persistants !
2021-03-14 Pour pilotage des LEDs sur un bureau => Démonstration
2021-03-24 Pour relevé temperature/humidité
2021-03-25 CANUINO: Passerelle basique Serie/Can avec Uno + CAN shield FMSSIMU: Simulateur de FMS avec Uno + CAN shield
2021-03-26 Creation jarduino 2
    - Une carte de commande à base de MSP 430 (A valider / revoir pnp cmd / alim 3.3 v)
    - Une carte IHM à LEDs
    [jarduino2.kicad_pcb, jarduino2.sch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]
2021-03-28 Ajout d'un scénario Violet/Violet pour avoir toutes les possibilités Ajout de 4 rangées de plus sur la partie du bas
2021-03-28 Réduire la durée et la fréquence du bip court
2021-04-13 Amélioration proto: - Diametre trous de fixation 4mm (avec compo sepcial) - SW1/SW2 echanges Batt/Sol
    [jarduino2.kicad_pcb, jarduino2.sch, jarduino2_ihm.kicad_pcb, jarduino2_ihm.sch]
2021-04-25 Quelques essais de CAO
    Envoyé:
    - Bouchon.stl
    - vis_interieur.stl
    - bouchon_filtrant-Bouchon3.stl
    A tester dès réception:
    - Filetage compatible ? Efficace ?
    [Bouchon.FCStd, Bouchon.stl, Ecrou.FCStd, bouchon_filtrant-Bouchon2.stl, bouchon_filtrant-Bouchon3.stl, bouchon_filtrant.FCStd, bouchon_filtrant2.FCStd, bouchon_filtrant3.FCStd]
2021-05-20 Bouchon 4 : - Pas de vis aux normes - Aggrandissement de l'embout - Aggrandissement des trous du filtre
    [bouchon_filtrant4.FCStd, bouchon_filtrant4.stl]
2021-05-24 Schéma jarduino2 avec nano: - RTC - 2 pompes - Borniers au lieu des connecteurs - composants traversants
    Composants trouvés lors de la réalisation du schéma précédent (jarduino2)
    Programme ino avec nano: MAQUETTE jarduino2.ino:
    - Lipo 3S comme batterie
    - BMS
    - Chargeur Mppt
    - DC DC 5V
    - Arduino nano + RTC + SD (Avec datalogger shield)
    - Arrose entre 7:00 et 7:15 et entre 19:00 et 19:15
    [jarduino2_nano.kicad_pcb, jarduino2_nano.sch]
2021-06-12 Clean up meca Create server side
    [Bouchon.FCStd, Bouchon.stl, Ecrou.FCStd, Ecrou_filetageARevoir.FCStd, bouchon_filtrant-Bouchon2.stl, bouchon_filtrant-Bouchon3.stl, bouchon_filtrant.FCStd, bouchon_filtrant2.FCStd]
2021-06-12 Ajout des autres types de message (msg, stats, cmds) Amélioration en cas d'erreurs
2021-06-24 Mise à jour suite changement de format des messages / multi client
2022-03-19 Ajout capteur de temp et hum + ext serie
    [jarduino2_nano.kicad_pcb, jarduino2_nano.sch]
2022-03-19 Amélioration 3d / libs
    [jarduino2_nano.kicad_pcb, jarduino2_nano.sch]
2022-06-10 Intégration de la lib msbus
    Gestion de quelques objets MODBUS pour les tests
2022-06-12 Ajout et mise au point des fonctions manquantes:
    - Lecture temp/hum
    - Acces remote
    - scheduler 1 horaire / jours de semaines
    - ...
    Premier test concluant
2022-06-13 Version programmée dans les jarduino aujourd'hui (Version 1)
2022-06-17 Mode autonome aussi pour la pompe 2
2022-06-18 Deplacement des fichiers du namo a part
    Ajout du script python pour configurer le jarduino
2022-07-20 Création de JardConfig pour configurer le Jarduino
2022-07-20 jard_nano: Ajout du mode veille et diverses améliorations
    - Ajout du mode veille (Extinction des LEDs si inactif, reveil avec boutons)
    - Ajout infos tensions/veille sur modbus
    - Port à 115200 (compatibilité time out modbus)
    - Gestion durées à cheval su 00:00
2022-07-20 jard_nano: Debug veille / Gestion jour de la semaine / réglage délai timer de pompe
    - Ajout de variables modbus (temps restant des timers)
    - Amélioration gestion heure
    - Correction erreur set de la date (jour/année inversés)
    - Reglage possible du timer de pompe (sauvé en EEPROM)
    - Débug mode veille (+ LED lente)
    [timer.cpp, timer.h]
2022-07-21 jard_nano: Remontée de bits manquant par MODBUS (veille, batt, ...) JardConfig: Ajout du monitoring
2022-07-24 jard_wifi: Creation du maître Modbus / Wifi avec ESP
    - Realisation du cycle de lecture (Coils + mesures communes, ...)
    - Ecriture d'une coil
    - Programmes de test (et du test du programme de test !)
2022-08-23 Ajout d'un serveur web par Wifi:
    - /test pour tester
    - /info pour récupérer les infos du jarduino
2022-09-09 Ajout de la veille du cpu Ralentissement du clignotement vert Veille IDLE dans l'inter cycle qui est reveillee par tier 1 Veille PWR quand off reveille sur on +/- 8s NB: Desoudage de la LED de la RTC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
2022-09-10 Preparation modèle 2023
    - Plus de hauteur sur pas de vis
    - 2 trous de plus sur le côté
    - Diamètre inférieurs à l'intérieur du tuyau
    [bouchon_filtrant4.FCStd]
2022-09-10 Erreur unité des timers veille et comm
2022-09-11 Création du bouchon pressostat Renommage bouchon filtrant
    [bouchon_filtrant.FCStd, bouchon_filtrant4.FCStd, bouchon_filtrant4.stl]
2022-09-11 Oubli source du pressostat
    [bouchon_pressostat.FCStd]
2022-09-11 STL envoyé en production (utilisation atelier mesh de freecad)
2022-09-11 Ajout MQTT et mode veille
    - Au boot, lecture modbus
    - Si minute mod 15 (ttes les 15 mins), on poursuit le boot sinon sommeil
    - Au démarrage, un log et une data sont envoyés
    - au bout de 4 mins on retourne en sommeil
    Pas au point car TX envoi tjs qqche au nano !! ?? => Boot ??? Boucle sans sleep ??
2022-10-08 Log toutes les minutes + log VCC et Batt + validation valeurs
2022-10-15 Amélioration du programme - V2.0
    - Doit fonctionner sans réseau
    - Changement bibliothèque MQTT
    - Détection move plus sensible mais pate à fix dans la cellule
    - Appui long sur selecteur = activation ou non ddu beep de move
    [sonnette.ino]
2022-11-05 Réalisation d'un embout à coller
    [embout_pressostat.FCStd]
2022-12-12 Ajout d'un timeout de comm => Coupe l'EV
2023-02-05 Carte techno traversant commande RS485
    [jard_rs485_slave.kicad_pcb, jard_rs485_slave.sch, jard_rs485_slave_avant.kicad_pcb]
2023-02-05 Version avec des modules
    [jard_rs485_slave_mods.kicad_pcb, jard_rs485_slave_mods.sch]
2023-02-06 Tout pret et testé niveau 458
    [jard_rs485_slave_mods.sch, nomenclature.xlsx]
2023-02-08 Carte en L
    [jard_rs485_slave_mods.kicad_pcb, jard_rs485_slave_mods_rect.kicad_pcb]
2023-02-21 Création d'une nouvelle carte pour le meuble à semi
    - Alim en 12V au lieu de 5V
    - 3 Alims 5V/2A pour LEDs RGB
    - 3 Alims 12V/2A pour LEDs horticoles ON/OFF
    - Fusibles sur PCB
    [semuino.kicad_pcb, semuino.sch]
2023-02-21 Erreur marquage fusible
    [semuino.kicad_pcb]
2023-03-02 Carte de commande éclairage semi
    - Alim 12V/10A
    - 3 sorties 12V/2A
    - 3 sorties RGB 5V/2A
    - RTC
    - Sonde température
    - extension ESP 01 Wifi
    - 1 entrée select
    - 1 entrée ON/OFF pour ESP 01
    [semuino.kicad_pcb, semuino.sch]
2023-03-02 Ajout d'une carte CMS générique: Commande pompes et EVs
    [jard_rs485_gen_slave_mods.kicad_pcb, jard_rs485_gen_slave_mods.sch, jard_rs485_slave_cms.kicad_pcb, jard_rs485_slave_cms.sch]
2023-03-05 Redesign avec 1 MOS et 2 entrées flowmeter Dimensions ajustées suite proto mécanique Ajout datasheets
    [jard_rs485_slave_mods.kicad_pcb, jard_rs485_slave_mods.sch]
2023-03-05 Ajustement sérigraphie
    [jard_rs485_slave_mods.kicad_pcb, jard_rs485_slave_mods.sch]
2023-03-06 Ajout AO de mesure de courant + mesure de tension
    [jard_rs485_slave_mods.kicad_pcb, jard_rs485_slave_mods.sch]
2023-03-07 Création maître OYA RS485
    - 1 Bus RS485 (Résistance configurable)
    - 1 Module Wemos (+ extension RTX SD possible)
    - 1 EEPROM 1k
    - 1 Sortie 12V/5A pilotable
    - 1 Alim DC/DC 5V
    [jard_485_wemos.kicad_pcb, jard_485_wemos.sch]
2023-03-08 Carte Wifi I/O
    [jard_wemos.kicad_pcb, jard_wemos.sch]
2023-03-23 Autre méthode pour filtrer (dans le réservoir)
    Filtre moins fin
    [filtreAR-Main.stl]
2023-03-24 Amélioration suite protos
    - Aggrandissement sérigraphie brochages
    - Correction inversion sérigraphie 1 et 4 de J2
    [jard_rs485_slave_mods.kicad_pcb]
2023-03-25 Correction épaisseur cyclindre pas de vis
    [filtreAR-Main.stl]
2023-03-27 Creation soft du Wifi I/O
    - Heartbeat pour commande MOS
    - Commande MOS
    - 3 niveaux N1, N2 et N3
    Et programme de test: Pilote la pompe en fonction de l'état de la cuve
2023-03-27 Finalisation carte Wifi I/O
    [jard_wemos.kicad_pcb, jard_wemos.sch]
2023-04-16 Suite montage des cartes
2023-04-22 Version qui fonctionne ce jour avec les cuves
2023-05-06 Tel que testé cette aprem avec 3 Wifi IOs
    [jard_wemos.kicad_pcb, jard_wemos.sch]
2023-05-08 Correction inversion RX/TX
    [jard_rs485_slave_mods.kicad_pcb, jard_rs485_slave_mods.sch]
2023-05-08 Agrandir sérigraphie connecteurs bus Correction erreur inversion sérigraphie 1 et 4 sur J2 Correction inversion RX/TX sur module RS485 Inversion sérigraphie Niveaux/Débit
    [jard_rs485_gen_slave_mods.kicad_pcb, jard_rs485_gen_slave_mods.sch, jard_rs485_slave_cms.kicad_pcb, jard_rs485_slave_cms.sch, jard_rs485_slave_mods.kicad_pcb, jard_rs485_slave_mods.sch]
2023-05-08 Tel que testé
2023-05-08 Préparation jarduino slave RS485 Rev B0
    [jard_rs485_slave_mods.kicad_pcb]
2023-05-08 Agrandissement des trous du module alim Changement de face de R8
    [jard_wemos.kicad_pcb]
2023-05-08 Changement alim 5V -> 3.3V
    [jard_wemos.kicad_pcb, jard_wemos.sch]
2023-05-08 Ménage
    [jard_rs485_gen_slave_mods.kicad_pcb, jard_rs485_gen_slave_mods.sch, jard_rs485_slave.kicad_pcb, jard_rs485_slave.sch, jard_rs485_slave_avant.kicad_pcb, jard_rs485_slave_cms.kicad_pcb, jard_rs485_slave_cms.sch]
2023-05-09 WS pour piloter les Wifi IO
    /states retourne l'état des modules et des remplissages (voir code)
    /rempli/<name>?on=1 active le remplissage <name>
    /rempli/<name>?limit_src=3 Arret du remplissage quand le niveau 3 est perdu sur la source
    /rempli/<name>?cons_tgt=2 Arret du remplissage quand le niveau 2 est atteint sur la destination
2023-06-18 Debug du maitre RS485 (comm de base avec 5 esclaves simulés par le prog python)
2023-06-19 Création carte maître RS485
    [board_rs485_master.kicad_pcb, board_rs485_master.sch]
2023-06-19 Première visu placement future carte
    [board_rs485_master.kicad_pcb]
2023-06-24 Consultation etat des oyas + diverses cmds term
2023-06-30 Simplification script de test python: Permet de gérer les 2 premiers Oyas quasiment automatiquement Activation de l'enable lu en eeprom.
2023-06-30 Debug et premier test avec terminal ok
    - Active désactive le maître
    - Pilote les oyas
2023-07-01 Ajout prise en charge bandeau LEDs et RTC Début du codage de la machine à états.
2023-07-07 Mise au point et test ce soir
    Plus d'erreurs avec bus correctement polarisé
    Ajout de stats d'erreurs
    Ajout Oya F
    [master.cpp, master.h]
2023-07-07 Test infini: Affiche les etats....
2023-07-08 Import avec eclipse pour plus de facilité Codage filtrage bouton test (Voir btn.hpp) Permier test complet RTC + Test.
2023-07-09 Creation d'un programme Wifi IO avec MQTT Diverses finalisations et tests: - Test 4 Oyas + pompe + master OK - Pompage wifi io tjs ok / boutlot avec Paul
    [jard_485_wemos.kicad_pcb, jard_485_wemos.sch, nomenclature.xlsx]
2023-07-10 Creation d'un service MQTT/Redis de gestion des Wifi IO
2023-07-14 Mise au point finale
    - Defines importants en haut du fichier
    - Tempo de mise en veille (+ temps d'envoyer un dernier message)
    - Ajout rssi, tick et pwr dans les datas
    - Gestion commande sleep et ping
    - Cas d'attente première réponse après boot
    Utilisation intensive cette après-midi
2023-07-16 - Ajout possibilité de log sur carte SD - Amélioration gestion dy cycle maitre (timer + start ssi IDLE) - blink + rapide qd on - Fonctions de test RTC deplacees (1 pour todo + 1 pour log) - Action su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
2023-07-16 Timeout de remplissage Diverses amélioration MAIS dégradation du réseau à cause des logs .....
2023-07-18 Correction veille (n'envoyer de message qu'une fois pour la veille) + champ sleep dans le module = (on a envoye une commande sleep). Disparaît un peu avant 1h
2023-07-18 Juste un client pour superviser les reservoirs
2023-07-18 De reference pour la periode de vacances
2023-08-06 Tel qu'utilisé pendant les vacances
2023-08-06 Durée totale max de 15 minutes (au lieu de 5) pour la duree d'arrosage Rework des logs (temp et hum par oya)
2023-08-20 Ajout du service de remplissage auto
2023-08-24 Correction remplissage de Paul
2023-09-03 Création d'un moniteur de cuve avec écran SSD1306
2023-09-21 SEMUINO: Rework de la carte
    - 3 LEDs 12V
    - 3 LEDs RGB (avec R de protection sur data)
    - 3 capteurs humidité sol
    - 1 Connecteur pour écran OLED
    - 1 RTC
    - 1 ESP01 pour le Wifi
    - Des fusibles
    - carte au format boîte de dérivation
    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
    [semuino.kicad_pcb, semuino.sch]
2023-09-24 Création maître des oyas
    [board_rs485_master.kicad_pcb, board_rs485_master.kicad_sch, board_rs485_master.sch]
2023-09-25 Routage carte + Ajout ESP 01 + ...
    [board_rs485_master.kicad_pcb, board_rs485_master.kicad_sch]
2023-09-25 Création esclave Oyas avec MSP430
    [jard_rs485_slave_msp430.kicad_pcb, jard_rs485_slave_msp430.kicad_sch]
2023-10-07 Passage kicat 7 + rework
    [semuino.kicad_pcb, semuino.kicad_sch, semuino.sch]
2023-10-07 Après nettoyage et vérification des règles
    [semuino.kicad_pcb, semuino.kicad_sch]
2023-10-23 Modification valeur des résistances de commande + Marquage future A1
    [semuino.kicad_pcb, semuino.kicad_sch]
2023-12-23 Passage carte semuino en A2 avec résistances 0R et commentaires/annotations suite mise en service de A0
    Petit loupé niveau alim du nano qui doit se faire sur la broche 5V et non 3.3 (qui est une sortie)
    [semuino.kicad_pcb, semuino.kicad_sch]
2023-12-23 Création du nouveau logiciel:
    - semuino_test: Logiciel pour tester la carte
    - semuino: Logiciel nano autonome
    - semuino_nano_slave: La nano est esclave (du ESP01)
    - semuino_nano_master_test: Un maitre nano pour tester l'esclave
2024-01-15 Ajout d'un warning sur le schéma pour indiquer que l'alimentation 5V doit être filtrée pour éviter les perturbations.
    Sinon les RGBs ne fonctionnent pas
    Plus tard, cette capa pourrait être intégrée à la carte ?
    [semuino.kicad_sch]
2024-01-15 Amélioration du programme de test avec #define pour utilisation du port série comme terminal de commandes +Mesures de conso ajoutées dans le readme.md
2024-01-20 Finalisattion du montage et tests
    Alim 5V KO => Utilisation alim extérieure 230V/5V/10A
2024-01-27 Premiere version de semuino (sans les LEDs RGB suite à la casse 12V sur 5V)
2024-01-28 Plage finale: de 6h00 à 22h00
2024-03-01 Réactivation des LEDs RGBs
    - Amélioration calcul de la luminosite
    - Les RGBs sont en rouge horticole
    - Periode de boost au milieu de la journee ou les RGBs deviennent blanches
2024-03-08 Nouvel algo + marquage V1.0
    - On monte en blanc avec les RGB seules de 6h à 7h (de 0 à 1000 LUX)
    - On allume les 12V + RGB en rouge horticole de 7h à 12h (1600 LUX)
    - On allume les 12V + RGB en blanc de 12h a 14h (2000 LUX)
    - On revient à 12V + RGB rouge de 14h à 21h (1600 LUX)
    - On descend en blanc avec les RGB seules de 21h à 22h (de 1000 LUX à 0)
2024-03-08 On vire le DHT car pas assez de memoire !
2024-03-13 Création du maître Semuino Wifi
    - Connecté en I2C au nano esclave semuino
    - AP Wifi ou simple client
    - Doit proposer le WS de pilotage du semuino
    - Gère la RTC de la carte
    - Lit et écrit l'EEPROM du nano via cmd speciales de I2C
    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
2024-03-14 Ajout de précisions sur le WS et le protocole I²C
2024-03-14 Finalisation esclave nano: - Retrait RGB du dessus (pas la place) - Gestion des modes RGB - Creation d'un .h commun pour I²C
    Maître ESP01:
    - Codage de la comm I²C
    - Ajout du module principal semuino.cpp qui contiendra l'appli
2024-03-16 Report et adaptation du code du semuino autonome Manque la partie config et LED
2024-03-16 Ajout du service de recuperation d'info en temps reel
2024-03-16 Complément de description
2024-03-16 Codage du mode de configuration. +Mise au point
2024-03-17 Ajout de commentaires Remplacement timer de SELECT
2024-03-17 Ajout de doxygen
2024-03-17 Affichage du mode avec la LED
2024-03-17 Passage à Kicad V7.0 Ajout de switches pour l'adresse de l'esclave
    [jard_rs485_slave_mods.kicad_pcb, jard_rs485_slave_mods.kicad_sch, jard_rs485_slave_mods.sch]
2024-03-24 Carte finie avec: - 1 EV/PMP - 2 niveaux - 1 débit - 1 DHT22 - Bus 485 - Alim 12V/5V
    Aux dimensions d'une petite boîte de dérivation rectangulaire (80mm x 30mm)
    [ES.kicad_sch, jard_rs485_slave_at328.kicad_pcb, jard_rs485_slave_at328.kicad_sch, power.kicad_sch, rs485.kicad_sch, uc.kicad_sch]
2024-03-24 Nouvel essai de routage avec en + LEDs
    [ES.kicad_sch, jard_rs485_slave_at328.kicad_pcb, uc.kicad_sch]
2024-03-26 Le maître des oyas devient un shield ATMEGA
    - ESP
    - LEDs RGB
    - Alim 5V
    - RS485
    - Alim 12V commutée
    - Mais manque SD card....
    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
    [board_rs485_master.kicad_pcb, board_rs485_master.kicad_sch, bus.kicad_sch, cpu.kicad_sch, power.kicad_sch, wifi.kicad_sch]
2024-03-29 Re-routage en gagnant de la place (à finir)
    [ES.kicad_sch, jard_rs485_slave_at328.kicad_pcb, jard_rs485_slave_at328.kicad_sch, power.kicad_sch, uc.kicad_sch]
2024-03-29 Fin du routage. Prêt pour revue.
    [jard_rs485_slave_at328.kicad_pcb]
2024-03-29 Petites coquilles de dossier
    [ES.kicad_sch, jard_rs485_slave_at328.kicad_pcb, jard_rs485_slave_at328.kicad_sch, power.kicad_sch, uc.kicad_sch]
2024-03-30 Candidate pour revue du master Oyas (avec modules en tant que shield MEGA)
    [board_rs485_master.kicad_pcb, board_rs485_master.kicad_sch, bus.kicad_sch, cpu.kicad_sch, power.kicad_sch, wifi.kicad_sch]
2024-03-31 Suppression esclave MSP430
    [jard_rs485_slave_msp430.kicad_pcb, jard_rs485_slave_msp430.kicad_sch]
2024-03-31 Finalisation dossier
    [board_rs485_master.kicad_pcb, board_rs485_master.kicad_sch, bus.kicad_sch, cpu.kicad_sch, power.kicad_sch, wifi.kicad_sch]
2024-03-31 Génération de BOM du maître des Oyas
    [board_rs485_master.xlsx]
2024-03-31 Suite revue: - Retrait limiteur de courant NOK pour flowmeter - Résolution des erreurs PCB
    [ES.kicad_sch, jard_rs485_slave_at328.kicad_pcb, jard_rs485_slave_at328.kicad_sch, power.kicad_sch, uc.kicad_sch]
2024-04-01 Correction empreinte résonateur
    [ES.kicad_sch, jard_rs485_slave_at328.kicad_pcb, jard_rs485_slave_at328.kicad_sch, power.kicad_sch, uc.kicad_sch]
2024-04-02 Correction erreur de MOS (N au lieu de P) + Saisie complete de la BOM
    [ES.kicad_sch, jard_rs485_slave_at328.kicad_pcb, jard_rs485_slave_at328.kicad_sch, power.kicad_sch, uc.kicad_sch]
2024-04-05 Détails
    [ES.kicad_sch, power.kicad_sch]
2024-04-06 Ajout des prix des composants
    [ES.kicad_sch, jard_rs485_slave_at328.xlsx, power.kicad_sch, uc.kicad_sch]
2024-04-08 Changement empreinte de D2 (trous + gros et 12mm long) Dessin sérigraphie J2 (sens de la sonde)
    [ES.kicad_sch, jard_rs485_slave_at328.kicad_pcb, power.kicad_sch, uc.kicad_sch]
2024-04-09 Amélioration suite remise en route:
    - Agrandissement trous des LEDs D1 et D3
    - Correction erreur type du MOS P GDS
    - Agrandissement empreintes de R5,R7,R13 et R10 + verticales
    - Ajout de la description des opérations de rework pour le MOD485
    - Ajout d'une interface pour adapter le bus (5V, A, B et Gnd)
    [board_rs485_master.kicad_pcb, board_rs485_master.kicad_sch, bus.kicad_sch, cpu.kicad_sch, power.kicad_sch, wifi.kicad_sch]
2024-04-13 Création d'une carte esclave basée sur des modules avec mix CMS/traversant au "petit" format
    [ES.kicad_sch, jard_rs485_slave_mods2.kicad_pcb, jard_rs485_slave_mods2.kicad_sch, power.kicad_sch, rs485.kicad_sch, uc.kicad_sch]
2024-04-14 Finitions avant envoi
    [ES.kicad_sch, jard_rs485_slave_mods2.kicad_pcb, jard_rs485_slave_mods2.kicad_sch, uc.kicad_sch]
2024-04-14 Modification titre du schéma + Nomenclature
    [ES.kicad_sch, jard_rs485_slave_mods2.kicad_sch, uc.kicad_sch]
2024-04-24 Déplacer C13 pour éviter le contact avec le port USB de la MEGA2460
    [board_rs485_master.kicad_pcb]
2024-04-24 Marquage date
    [board_rs485_master.kicad_pcb]
2024-04-24 Création du programme de test fabrication ok
2024-04-25 Finalisation des tests (comm wifi)
2024-04-25 Correction de l'inversion RX/TX du module Wifi
    [board_rs485_master.kicad_pcb, board_rs485_master.kicad_sch, bus.kicad_sch, cpu.kicad_sch, power.kicad_sch, wifi.kicad_sch]
2024-04-25 Creation du programme Wifi (pour l'instant un test de comm)
2024-04-26 Changement de la logique de commande des PWR Wifi et LEDs (avec un npn en plus)
    [board_rs485_master.kicad_pcb, board_rs485_master.kicad_sch, bus.kicad_sch, cpu.kicad_sch, power.kicad_sch, wifi.kicad_sch]
2024-04-26 Titres + finitions (vias)
    [board_rs485_master.kicad_pcb, board_rs485_master.kicad_sch, bus.kicad_sch, cpu.kicad_sch, power.kicad_sch, wifi.kicad_sch]
2024-04-27 Déplacement piste LED car trop proche du bord
    [ES.kicad_sch, jard_rs485_slave_mods2.kicad_pcb, jard_rs485_slave_mods2.kicad_sch, uc.kicad_sch]
2024-04-27 Création programme de test oya
2024-05-01 Relier RST et D0 pour la sortie de veille (strap sur A0 et B0)
    [jard_wemos.kicad_pcb, jard_wemos.kicad_sch, jard_wemos.sch]
2024-05-01 Changement des paramètres: - 3 minutes pour la tentative de comm apres boot (au lieu de 2) - repetition comm toutes les 20s lors du boot (au lieu de 30) - Reveil toutes les 30 mins (au lieu de toutes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
2024-05-01 Filtrage acquisition analogique et conversion échelle dixième de volts (120 = 12 V)
2024-05-03 REWORK complet du soft RS485 Maître/Esclave. Partie protocole OK. A finaliser...
    [nomenclature.xlsx]
2024-05-03 Fin de codage esclave + début des tests
2024-05-04 Testeur de LEDs
2024-05-04 Inversion RX/TX 485
    [ES.kicad_sch, jard_rs485_slave_mods2.kicad_pcb, jard_rs485_slave_mods2.kicad_sch, uc.kicad_sch]
2024-05-05 Suppression du module RS485 et remplacement par le CI MAX485E lui-même. Preparation version G...
    [ES.kicad_sch, jard_rs485_slave_mods2.kicad_pcb, jard_rs485_slave_mods2.kicad_sch, uc.kicad_sch]
2024-05-05 Finitions avant production
    [ES.kicad_sch, jard_rs485_slave_mods2.kicad_pcb, jard_rs485_slave_mods2.kicad_sch]
2024-05-06 Réaffactation des commandes PWR de Wifi et LEDs (compatibilité soft) + suppression de la sheet Wifi sur le schéma (regreoupé dans UC)
    [board_rs485_master.kicad_pcb, board_rs485_master.kicad_sch, bus.kicad_sch, cpu.kicad_sch, power.kicad_sch, wifi.kicad_sch]
2024-05-14 Amélioration programmation adresse et timers de timeout Ajout de la commande de RAZ du temps total en s
    - Clignote lentement (1s) = Adresse non initialisee
    - Clignote brièvement toutes les secondes = Programme init en cours (il faut mettre un prog normal)
    - Clignote rapidement (200ms) = sortie activee
    - Clignote plus lentement (500ms) = pas de sync donc pas de remonte de datas vers le maitre
    - Fixe = Reseau ok (cmd + sync)
    - Eteint = Pas de reseau
2024-05-15 Correction pilotage des EVs des Oyas + tests
    [master.cpp]
2024-05-17 Agrandissement pastilles Mod RS485
    [ES.kicad_sch, jard_rs485_slave_mods2.kicad_pcb, jard_rs485_slave_mods2.kicad_sch, uc.kicad_sch]
2024-05-18 Il faut les pullup internes pour la Rev Ex
2024-05-18 Ajout infos oyas ds terminal (volts, temps, ...) Config par défaut à 6 esclaves dont 1 pompe
2024-05-19 Finalisation Comm wifi avec etat des commandes distantes Creation machine à états de gestion de l'appli (manager)
2024-05-19 Creation programme de test pour répondre "pong" au "ping" du master
2024-05-20 Fin test du jour avec pilotage des oyas à distance
2024-05-21 Creation Gestion des maîtres des oyas (version avec bête pooling initié par le serveur) Modif wemos mqtt: Par defaut, l'application est OFF (suite coupure secteur par exemple)
2024-06-01 Debug: Le reseau se coupe au bout d'un moment (Rev Gx + Nano 168 mais ok avec Nano 328p) loop n'est plus appelee...
    - On retire tx des parametres du begin du slavemgr
    - Ajout de traces (cmd + sync) sur des broches
    - Ajout trame raz errors
    - Amelioration retour loop slavemgr
    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
2024-06-02 Mise au point esclave (probleme d'instabilite car depassement de pile)
2024-06-08 Tentative de debug suite pb instabilité (finalement bug dans core arduino 168)
2024-06-08 Ajustement tmt de sync à 6 s (time cmd a 4s)
2024-06-08 Re-programmation de tous les premiers Oyas @1 à @8 (et passage au Nano 328)
2024-06-09 Mise au point avec les oyas du reduit +Ajout du mode display par appui sur test
2024-06-10 Carte datalogguer RS485
    [logger.kicad_pcb, logger.kicad_sch]
2024-06-10 Retouche avant envoi
    [logger.kicad_pcb]
2024-06-11 Amélioration découplage RS485, MOS sur autre face
    [ES.kicad_sch, jard_rs485_slave_mods2.kicad_pcb, jard_rs485_slave_mods2.kicad_sch, uc.kicad_sch]
2024-06-23 Refactoring du remplissage: On ne rempli plus que les low Ajout du logger Ajout d'un etat check wifi
2024-06-27 Note à faire
    [jard_wemos.kicad_sch]
2024-07-01 Annotations sur le schéma (cond.603->805, Eq Transistor npn)
    [ES.kicad_sch, jard_rs485_slave_mods2.kicad_sch]
2024-07-04 Integration de la lib mdbus directement dans les sources du jarduino
2024-07-04 Config pour datalogger
    [config.txt]
2024-07-04 - Ajout fonctions Raz et Ping - Timeout reset et plein retouches et differentiation petits OYAs - Mode recherche Wifi avec LED jaune (non testé: A finaliser) - Prise en charge mecanisme de commandes 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
    [master.cpp, master.h]
2024-07-07 Ajout d'un prog de test des esclaves avec IHM Debut rework Wifi avec une machine a états qui gere l'envoi des donnees ...
    [master.cpp, master.h]
2024-07-13 Rework pour tenter de corriger le déclenchement intempestif de la pompe Visiblement du a l'etat de la broche en mode veille. Desormais elle sera fixee a low. Ajout de commandes pour tester les watchd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
    [timer.cpp, timer.h]
2024-07-14 Ajustement Reduit (moins de temps de remplissage)
2024-07-17 Rework comm et tentative desactivation pour revenir à un prog OK sans comm
    [master.cpp, master.h]
2024-07-18 Logger les oyas
2024-07-20 Correction coquille algo de remplissage (chronos incorrects)
2024-08-24 Suppression fichiers copies vers le nouveau repo Jarduino
    [ES.kicad_sch, Ecrou_filetageARevoir.FCStd, board_rs485_master.kicad_pcb, board_rs485_master.kicad_sch, board_rs485_master.xlsx, bouchon_filtrant.FCStd, bouchon_pressostat.FCStd, bouchon_pressostat.stl]
2024-08-24 Suppression carte jarduino2
    [jarduino2.kicad_pcb, jarduino2.sch, jarduino2_nano.kicad_pcb, jarduino2_nano.sch]
2024-08-24 Suppression suite transfert vers repo jarduino
    [jard_wemos.kicad_pcb, jard_wemos.kicad_sch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]
2024-09-28 Sans les traces (oubli)
2025-02-15 Ajout de la gestion heure hiver/ete
2026-10-13 Changement connecteur header en socket
